SEspe/RemoteStart/docs/hardware/MasterRemote_interface_schematic_marked.jpg

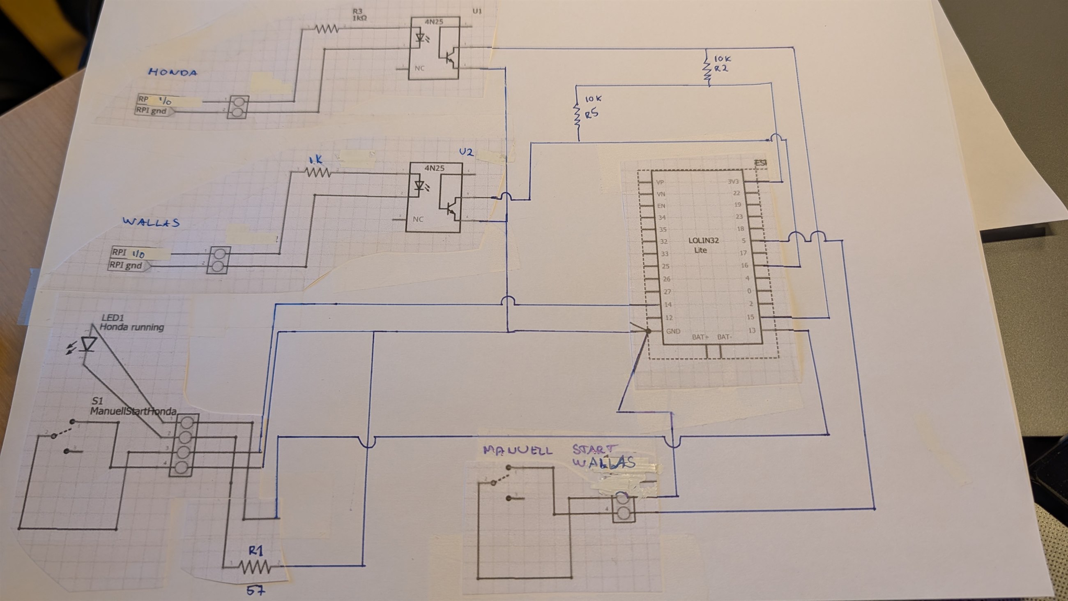
docs/hardware/MasterRemote_interface_schematic_marked.jpg
