SEspe/RemoteStart/docs/hardware/Wallas_connector_onoff_thermostat.png

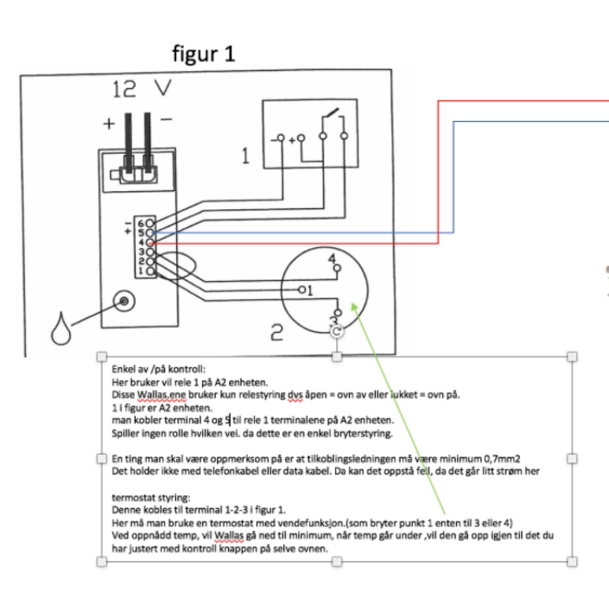
docs/hardware/Wallas_connector_onoff_thermostat.png
