SEspe/RemoteStart/FSD_RemoteStart_CHANGELOG.md

# FSD changelog — Remote Start System

The development record for `FSD_RemoteStart.md`. Every change to the
specification lands here, newest first.

The two files have different jobs. **`FSD_RemoteStart.md` is the clean current
specification**: what the system is required to do, in the present tense, with
no history in it. **This file is how it got that way** — what changed at each
version, and more importantly *why*, so a decision that looks arbitrary later
can be traced back to the evidence that forced it.

Read the FSD to build the thing. Read this when you want to know why it says
what it says, or before reopening a question that was already settled. This
project is the origin of the house conventions the sibling projects inherit —
the provisioning portal, the tab layout, the OTA flow — so several entries here
are cited by name in those projects' specifications.

Entry format: `- vX.Y — **Title.** what + why + how`, with per-unit firmware
versions named where they changed (MasterRemote, SlaveHonda, SlaveWallas,
ESPNowRelay). A functional change is not done until the code, the unit version
bumps, and an entry here land together.

---

- v1.62 — **The ESP32-C6 relay module's relay is on GPIO19** — the pin SlaveWallas already drives, so the board runs the standard SlaveWallas release with no board setting. Confirmed on the bench (board MAC `98:A3:16:9D:8D:0C`, SlaveWallas 1.8.0, flashed with the browser flasher): three Start/Stop pulses through `/api/wallas/start|stop` gave three audible on/off clicks, with `relay` and GPIO19 following, active HIGH. Hardware Guide §3.2 updated from "not yet known"; GPIO18/GPIO23 have nothing attached on this board. Documentation only.

- v1.61 — **Every unit answers on a fixed name, and the setup page takes you there by itself** (§4). MasterRemote 1.9.0, SlaveHonda 1.5.0, SlaveWallas 1.8.0, ESPNowRelay 1.3.0.
  - **Why:** after entering WiFi details in the portal the unit rebooted onto the home network at a DHCP address nobody was told; finding it meant digging through the router.
  - **mDNS + DHCP hostname on all four units:** `masterremote`, `slavehonda`, `slavewallas`, `espnowrelay` (`MDNS_HOSTNAME` in each `version.h`). The hostname is set on the STA netif before DHCP starts, so router client lists show it; mDNS (`espressif/mdns`, the same component as BirdBox) announces `<name>.local` and an `_http._tcp` service. Best-effort: a failed `mdns_init()` only logs. Same-subnet only.
  - **Self-redirecting Saved! page:** after **Connect & Save** (portal or WiFi tab) or **Save & Apply** (IP Configuration), the page polls `http://<name>.local/api/version` (`no-cors` fetch, 3 s abort, every 2 s from 6 s after saving, ~90 s in all) and opens `http://<name>.local/` as soon as the unit answers. The manual fallback stays on the page: the link, the router client list, and for the slaves MasterRemote's Nodes tab. One `SAVED_PAGE(msg)` macro per unit replaces the two old static pages.
  - **Told up front:** a note under each of those three buttons says where the page will go after saving. The portal's note adds that a phone's automatic "sign in to network" window can't follow (it closes with the AP), so 192.168.4.1 should be opened in a normal browser tab.
  - README First Startup, the browser flasher's instructions and FSD §4 (table now lists all four units with their address after setup) describe the new flow.
  - **Verified on the test SlaveWallas** (1.8.0, PC on the same 192.168.10.x subnet): `slavewallas.local` resolved to .220 and served the UI; a real save (IP Configuration, settings unchanged) returned the new Saved! page, the unit rebooted, and headless Chrome followed the page to `http://slavewallas.local/` on its own; settings came back unchanged. MasterRemote, SlaveHonda and ESPNowRelay built and their UI JavaScript parses, but were not run (no bench units online for them).

- v1.60 — **MIT license added** (`LICENSE`, "Copyright (c) 2026 SEspe", same as BirdBox). Its as-is / no-liability clause backs the safety disclaimer (v1.59). The README gains a License section, which also states that the Wallas wiring drawing and the relay-module product photo in `docs/hardware/` are third-party material, included for reference and not covered by the MIT license. Documentation only.

- v1.59 — **Safety precautions and an at-your-own-risk disclaimer for connecting SlaveWallas to a heater.** Documentation only. The Wallas wiring (Hardware Guide §3.1–3.2) is worked out from a third-party drawing for one older Wallas M26 and is not verified for anyone else's heater, while the system starts a fuel-burning appliance remotely and on a timer, possibly unattended. Hardware Guide 1.2 now opens §3 with a prominent CAUTION block: check the heater's own documentation or a dealer, measure terminals 4/5/6, keep the heater's own safety functions in charge, fuse the feed, use NO and ≥ 0.7 mm², bench-test then test at the heater while present, only use remote/timer starts where unattended running is safe — and do not connect if any of it cannot be confirmed. It ends with a no-warranty, no-liability, at-your-own-risk disclaimer. A short banner at the top of the guide, a reminder in §3.2, and a "Safety and disclaimer" section in the README point to it.

- v1.58 — **Removed the old Arduino sketches.** Repository cleanup only — no firmware change. Five `.ino` files were still committed although no build used them and the FSD and README both say the project has no Arduino code: `MasterRemote/MasterHonda.ino`, `SlaveHonda/SlaveHonda.ino`, `SlaveWallas/SlaveWallas.ino`, and `SlaveWallas/SlaveWallas8266.ino` plus an identical copy under `SlaveWallas/Archive/`. They remain in git history; the last commit containing them is `fbca35c`, so e.g. `git show fbca35c:MasterRemote/MasterHonda.ino` prints one.

- v1.57 — **Wallas wiring documented; ESP32-C6 relay module planned for SlaveWallas** ([Hardware Guide §3.1–3.2](docs/HARDWARE.md#31-wallas-heater-control-terminals)). Documentation only — no firmware change. The heater's 12 V control block: terminal 6 −, 5 +, and joining 4 to 5 runs the heater (open = off); terminals 1–2–3 are an alternative thermostat input, unused. SlaveWallas is wired as: module supply from 5/6, relay COM to 5, NO to 4 — NO so that an unpowered board leaves the heater off. The vendor drawing's note to use at least 0.7 mm² wire is carried over. The planned board is an ESP32-C6 single-relay module (DC 5–60 V, Type-C, BOOT/RST); its relay GPIO is not published and is to be found with the Debug tab before installation. The connector has no running-feedback signal, so GPIO18 stays unconnected. §2.4 now points to the guide.

- v1.56 — **SlaveWallas runs standalone; the weekly timer lives on both units and stays in sync** (new §3.5; §3.3, §3.4, §6.1a, §6.2, §13). MasterRemote 1.8.2, SlaveWallas 1.7.2, ESPNowRelay 1.2.0; SlaveHonda unchanged.
  - **Why:** SlaveWallas could only ever do what MasterRemote last told it. Without MasterRemote there was no way to run the heater, and if MasterRemote vanished mid-run the relay stayed in its last state indefinitely.
  - **Behaviour, as chosen by the user:** standalone is automatic — no Master beacon for 30 s (the existing stale rule), or none since boot. Standalone, the relay follows SlaveWallas's own Start/Stop and own weekly timer; so losing Master drops Master's sources and the heater turns off unless a local source wants it. With Master present, the relay follows Master's command as before, and SlaveWallas's Start/Stop are passed to Master and act exactly like Master's own buttons, so both pages agree. A local Start made while standalone is handed to Master when it returns, so the heater does not drop at the hand-over.
  - **Timer sync, newest edit wins:** both units keep the 7-day table plus a `walltrev` revision in NVS. An edit sets rev to the edit's wall-clock time (NTP; never lower than rev + 1). Each side sends its table every 60 s while the other is present, 1 s after an edit and immediately on (re)contact; the higher rev is adopted, a lower one is answered with the newer table. A pre-existing MasterRemote table counts as rev 1, so it is copied to a fresh SlaveWallas.
  - **Two new ESP-NOW messages** — `wallas_timer_msg_t` (71 bytes) and `wallas_webcmd_msg_t` (33 bytes), packed and size-asserted on every unit, since all units dispatch on frame length. **ESPNowRelay 1.2.0 forwards both;** an older relay would count them as "Other" and drop them, so with a relay in the path all three units must be updated together.
  - **SlaveWallas UI:** Status tab gains a Mode line and Start Wallas / Stop Wallas buttons; a new Weekly Timer tab (same table and staged Set as Master's). New `/api/wallas/start|stop`, `/api/timer`, `/api/timer/set`; `/api/status` adds `sa`/`lw`/`ta`. SlaveWallas now runs SNTP (same server and TZ as Master). `max_uri_handlers` 20 → 28.
  - **Weekly Timer tabs refresh themselves (both units).** The tab polls every 2 s but redraws only when `rev` changed, and never over unsaved edits or a field being typed in — then a note says the timer changed on the other unit, with a link to load the latest. Previously Master's tab only loaded on open, which made sync invisible until a manual reload. Also removed a stray "…" placeholder that rendered above the timer table.
  - **Master side:** command force-sent when SlaveWallas (re)registers or presses a button; `/api/timer` reports `rev`; `.warn` style added (the clock line was unstyled).
  - **Verified on the test pair** (MasterRemote .224, SlaveWallas .220, no relay): Start/Stop on SlaveWallas switched Master's `gWS` and the slave relay; timer edits went across in both directions within ~2 s with matching rev; with MasterRemote unplugged SlaveWallas went standalone (`sa:true`), its Start/Stop drove the relay directly, and a timer window covering the current time switched the relay on (`ta:true`) and off again when removed; after a reboot with no Master it came up standalone.

- v1.55 — **MasterRemote inputs: an unconnected input no longer demands a start, and each input can be switched off as a source** (§2.2, §6). MasterRemote 1.7.0; the other units are unchanged.
  - **Found on a bare test board flashed with the new browser flasher:** with nothing wired, MasterRemote 1.6.15 commanded both Honda and Wallas on. GPIO15/GPIO4 had their internal pull-ups disabled and relied on the interface board's 10 kΩ pull-ups, so without the board they read LOW, which is "Victron demands start". GPIO14/GPIO5 read HIGH through their pull-ups, which is a manual switch in its On position. The test SlaveWallas really did switch its relay on. The same thing would happen in the installation if the interface-board connector came loose or a switch wire broke, and for Honda a start command cranks the engine.
  - **Internal pull-ups enabled on GPIO15 and GPIO4.** With the board fitted this only adds to R2/R5 and the opto still pulls the pin LOW. Without it, the pin now reads HIGH = idle. Verified on the bare board: GPIO4/GPIO15 read 0 on 1.6.15, 1 on 1.7.0.
  - **Input enable mask.** The manual switches ground their pin when Off, so an open circuit reads On whatever the firmware does; the wiring fix is to use the switches' other contact. Until then, and for any unit with an input not fitted, the Debug tab has an **Input Sources** card with one checkbox per input, staged and saved with one **Set** button like the Weekly Timer. New `POST /api/inputs/set?mask=0-15`, NVS u8 `inen`, `inEn` in `/api/status`, all enabled by default. Pin Status labels a disabled input "(disabled)" but keeps showing its pin.
  - **One compute function per command.** The OR of all sources was written out at four sites per command (both ISRs, the boot read, `timer_task`, the web stop handlers). Adding the mask to each copy would have repeated the bug class in §12 that has already happened three times, so all sites now call `honda_cmd_compute()`/`wallas_cmd_compute()`. Changing the mask recomputes both commands at once and force-sends Honda if it changed.
  - `max_uri_handlers` raised 28 → 32 (27 routes now).
  - Verified on the test pair (MasterRemote .224, SlaveWallas .220): mask 5 (manual switches off) dropped `gHS`/`gWS` to false and the SlaveWallas relay went off; mask 99 was rejected with 400; the mask survived a reboot.

- v1.54 — **Browser flasher for a new unit, on GitHub Pages** (§11.1). A new board can now be flashed from https://sespe.github.io/RemoteStart/ in Chrome or Edge, with no ESP-IDF or esptool on that computer — the same esp-web-tools pattern as the BirdBox project, extended to four units on two chip families. CI/docs only — no firmware, endpoint or NVS change, and no unit version bump.
  - **New `.github/workflows/webflash-pages.yml`:** on a push to `master` that touches a unit or the flasher, builds all four units in a matrix and deploys each one's bootloader, partition table, OTA data and app image plus a per-unit `manifest.json` to Pages. One `docs/webflash/manifest.template.json` serves all four; the matrix fills in the unit, `FIRMWARE_VERSION`, chip family and **bootloader offset, which differs by chip — 0x1000 on ESP32, 0x0 on ESP32-C6** (read from each unit's `flasher_args.json`). Getting that wrong would write a C6 bootloader where the ROM never looks.
  - **Per-unit buttons, not one:** the four units are four different firmwares, so the page has one install button per unit. esp-web-tools refuses a chip-family mismatch, so the C6 units are protected against the wrong board; MasterRemote and SlaveHonda share the ESP32 family and cannot be told apart, which the page warns about.
  - **Erase is offered by default** (`new_install_prompt_erase`), because a plain flash onto a board with unknown history once left a new MasterRemote's radio silent while its logs reported a running SoftAP.
  - **Fixed the release notes' USB instructions:** they told the reader to `write_flash 0x10000 <Unit>_<ver>.bin` alone, which on a blank board leaves no bootloader or partition table and does not boot. They now point at the browser flasher or `idf.py erase-flash flash`, and say the release `.bin` files are OTA app images. §8 says the same.
  - `README.md` "Build & Flash" now leads with the browser flasher.

- v1.53 — **Specification and history split into two files.** Documentation only — no firmware, endpoint or NVS change, and no unit version bump. `FSD_RemoteStart.md` becomes the clean current specification — present tense, no history — and this file takes the development record, all 51 entries moved across byte-for-byte. This FSD was the mildest of the three (68 lines of changelog against 782 total), but the same split is now applied across all four sibling projects so the house convention stays uniform; a half-migrated family is worse than either extreme. **One internal cross-reference was broken by the move and is fixed:** §4's static-IP note cited "§1 changelog", which no longer exists in this document, and now names the changelog file. The other in-document references — to the v1.25, v1.27 and v1.31 entries in §10 and §12 — still resolve, because the FSD's new header says where the changelog lives. `README.md` lists both files.

- v1.52 — **Hardware documentation: new [docs/HARDWARE.md](docs/HARDWARE.md) plus the three source drawings under `docs/hardware/`.** Documentation only — no firmware, endpoint or NVS change, and no unit version bump. Covers MasterRemote's opto-isolated Venus (Raspberry Pi) interface board, the manual-switch/indicator field wiring and terminal-block assignments, the end-to-end Honda start flow through to the EU7000is remote connector, and the relay timing.
  - **Corrected §2.2: GPIO15 (Honda Start, Victron relay) is active LOW, not active HIGH.** The table had claimed active HIGH since v1.14 while `main.c` has always read it as `!gpio_get_level(PIN_HONDA_START)`. The schematic settles it — GPIO15 is fed by optocoupler U1's open collector with an external 10 kΩ pull-up, and the internal pull-up is disabled in `gpio_init()`. Confirmed live on 2026-08-10: with the system idle, `/api/gpio/status` reports GPIO15 = 1 and GPIO4 = 1, which is only possible with external pull-ups fitted, and `/api/status` correspondingly reads `pHS:false`/`pWS:false`. Both Victron inputs use the same polarity; the old text's "opposite polarity of GPIO15" note on the GPIO4 row was wrong for the same reason and is removed. No code changed — the firmware was already correct, only the document was not.
  - The **redrawn** schematic (`MasterRemote_interface_schematic.png`) was found to contain five transcription errors relative to the hand-marked original, catalogued in Hardware Guide §6 — most consequentially a right-header pin-label list with `23` and `15` duplicated and `5`/`2` missing, which shifts every row from the third down and makes the Wallas opto appear to land on GPIO16 rather than GPIO4. The marked original photo is kept alongside it and is the one to wire from until the redraw is fixed.
- v1.51 — **Collapsed the ~70 px of blank space under the "Install from GitHub Releases" card's buttons**, on all four units. The card reserved permanent room for controls that only appear once an install is under way: a `<br>` after the always-hidden release `<select>`, plus two `.prog` status lines each holding `min-height:1.2em` while empty. Removed the `<br>` (the select is switched to `display:block` when populated, so the Install button still lands on its own line) and added `.prog:empty{display:none}`, which collapses every idle status line on the page rather than just this card's. Purely CSS/markup; no endpoint, JSON, or NVS change. MasterRemote 1.6.15, SlaveHonda 1.4.13, SlaveWallas 1.6.13, ESPNowRelay 1.1.12.
- v1.50 — **Two fixes to v1.49's version table, both reported from the live UI.**
  - **MasterRemote showed no versions for the slaves.** v1.49 had the page fetch `/api/version` from each slave's own address; a browser treats `http://<slave-ip>/` as a different origin from the page it loaded off MasterRemote, and those reads came back empty in practice even with `Access-Control-Allow-Origin: *` on the response. Replaced by **`GET /api/versions[?relay=<ip>]` on MasterRemote**, which collects the other units' `/api/version` itself over plain LAN HTTP (4 s timeout each, so one silent unit can't stall the table) and returns all four rows to a same-origin caller. Slave addresses still come from the ESP-NOW roster; ESPNowRelay's is still typed once into the card and kept in the browser, now passed through as a query parameter (validated against an IPv4 alphabet before it goes into a URL). `/api/version` stays on every unit — it is the data source, and still CORS-open for direct use.
  - **24-hour clock everywhere.** `new Date().toLocaleTimeString()` follows the viewing browser's locale and was rendering as `7:43:39 PM`. All UI timestamps (Status/Nodes "Updated:", the version card) now go through one `hms()` helper producing zero-padded `HH:MM:SS`, on all four units.
  - Also: a stored version read from a pre-v1.49 image is a `git describe` string that already starts with `v`, which rendered as `vv1.31.0`; the leading `v` is now stripped before the display prefix is added.
  MasterRemote 1.6.14, SlaveHonda 1.4.12, SlaveWallas 1.6.12, ESPNowRelay 1.1.11.
- v1.49 — **Firmware Versions table on the OTA tab: GitHub / Stored / Installed side by side, on all four units** (§6.6, §7.3). Each unit's OTA tab now opens with a version card showing what the newest published release offers for it (**GitHub**), what sits in its inactive OTA slot (**Stored** — the previous image, still bootable), and what it is running (**Installed**); the Installed box turns amber when GitHub has a newer build. **MasterRemote's card lists all four units in one table**, like the reference layout the feature was modelled on.
  - **New `GET /api/version`** on every unit: `{"name","installed","stored","storedName","running"}`. `stored` comes from `esp_ota_get_partition_description()` on `esp_ota_get_next_update_partition()`, and is empty when that slot has never been written or holds no valid image. Served with `Access-Control-Allow-Origin: *` on purpose — MasterRemote's page fetches this same endpoint from the other units' addresses, which is cross-origin from the browser's point of view; the payload is read-only version data on a LAN-only device.
  - **New `GET /api/ota/github/latest`** on every unit: the newest published version per unit, `{"MasterRemote":"…","SlaveHonda":"…","SlaveWallas":"…","ESPNowRelay":"…"}`, parsed out of the `<Unit>_v<ver>.bin` asset filenames. Reuses v1.48's streaming scanner (never materialises the listing) and captures only `browser_download_url`, stopping as soon as all four are known — normally inside the first release, since a unified `v*` tag carries all four bins. All four firmwares carry the identical four-unit handler even though only MasterRemote's page reads more than its own key.
  - **`PROJECT_VER` is now derived from `main/version.h` in each unit's top-level `CMakeLists.txt`**, so the app descriptor baked into the image carries `FIRMWARE_VERSION`. Without this, ESP-IDF fills the descriptor from `git describe`, which says nothing about the per-unit firmware version — and the descriptor is the only way to read a *passive* partition's version. **Consequence on first deploy: the Stored column shows a `git describe`-style string (or blank) until each unit has been updated twice**, since the image already in the passive slot predates this change.
  - **How MasterRemote resolves the other three addresses:** SlaveHonda and SlaveWallas come from `/api/nodes` (so the table follows a DHCP move), while **ESPNowRelay is deliberately absent from the ESP-NOW roster** — the repeater is transparent and never announces itself (§13) — so its address is typed once into a field on the card and kept in the browser's `localStorage`. That was chosen over adding a relay→Master ESP-NOW message type purely to feed a display, since the repeater's whole design premise is that it changes nothing about the other units' firmware. A blank or unreachable address just leaves that row's cells empty; per-unit fetches are abort-timeout bounded so one silent unit can't stall the table.
  - ESPNowRelay's `max_uri_handlers` raised 16 → 20 for the two new routes (the other three units already had margin).
  MasterRemote 1.6.13, SlaveHonda 1.4.11, SlaveWallas 1.6.11, ESPNowRelay 1.1.10. No NVS, data-model, or wire-format change.
- v1.48 — **Two independent defects were breaking the GitHub-release OTA feature; both are fixed, plus a "Go GitHub" link and MasterRemote's missing Manual GPIO Test card.** User reported the feature not working on all units. Probing SlaveHonda live separated it into two unrelated causes that had been mistaken for one:
  - **(1) Release listing ran out of heap.** `GET /api/ota/github/releases` buffered the whole API response and handed it to `cJSON`. Each published release carries four per-unit assets of ~20 JSON fields, so the listing had grown past **68 KB**, and a full parse needs the raw buffer plus a tree several times its size against a ~200 KB heap. MasterRemote failed **3/3** with `Bad GitHub response` (the `cJSON_Parse()` branch — the malloc succeeded, the parse then had nothing left), its heap low-water plunging ~98 KB per attempt, while SlaveHonda with a little more headroom still squeaked through **9/9**. That difference is why it looked intermittent. Rewritten as a **byte-at-a-time streaming scanner** (`gh_key_feed()`) that never materialises the document: it watches for four literal keys, exploiting GitHub's field order (`tag_name`/`published_at` precede a release's `assets`; within an asset `size` precedes `browser_download_url`), takes the asset filename from the URL's own last path segment, and dedupes by tag so one asset per release is emitted. Peak cost no longer depends on the release count — which matters because the payload grows with every release, so trimming `per_page` would only have postponed this. Output JSON is byte-identical to the old implementation (verified live: same 1348 bytes, same 7 releases). Also now tolerates a chunked response, since the scanner no longer needs `Content-Length`, and a non-200 reply reports the actual status code instead of a generic string.
  - **(2) Outbound TLS could not get a socket.** With the listing fixed, `POST /api/ota/github/install` still failed instantly with `begin:ESP_ERR_HTTP_CONNECT`, trace `le=32770` = `0x8002` = **`ESP_ERR_ESP_TLS_CANNOT_CREATE_SOCKET`** — `socket()` itself failing, nothing to do with TLS or the buffer sizes v1.46 fixed. `CONFIG_LWIP_MAX_SOCKETS` was **10**, while httpd holds a listener, a control socket, and up to 7 sessions = 9, leaving exactly **one** descriptor for everything else. A browser parked on a polling tab fills all 7 session slots (they are keep-alive and `lru_purge_enable` only reclaims one when a *new* connection needs it, so an idle wait does not help — confirmed: still failing after 60 s quiet), so the device had no descriptor left to open its own outbound connection. Proven by a discriminating test: after a reboot with no preceding traffic the identical install ran **0%→100% success**. Fixed by raising `CONFIG_LWIP_MAX_SOCKETS` to **16** in all four `sdkconfig.defaults`, and `cfg.max_open_sockets` is now set explicitly with a comment recording that it is one half of a budget, so a future change to either number is visibly a trade against the other. This affected *both* the listing fetch and the install, so it was very likely also a contributor to the user-visible "Refresh Releases doesn't work".
  - **(3) "Go GitHub" link** added beside Refresh Releases on every unit's OTA tab, opening `github.com/SEspe/RemoteStart` in a new tab (`rel="noopener"`). Styled via a new `a.up.gh-link` rule because the existing `button.up` selector is element-qualified and gives an `<a>` none of its padding or colour.
  - **(4) MasterRemote gained the Manual GPIO Test card** its Debug tab was missing (the other three units had it since v1.40). Same pin matrix, same reserved-pin rules, same `/api/gpio/set` + `/api/gpio/status` endpoints. **One difference is called out in its UI and worth knowing:** unlike the slaves, whose drivable pins are their own relay outputs, MasterRemote's Victron-relay and manual-switch pins are *inputs fed by external contacts* (§2) — the strapping-pin rules already exclude GPIO5/GPIO15, leaving **GPIO4 and GPIO14** as pins where forcing OUTPUT puts the pad in contention with the external wiring. Reading their dots is always safe; driving them is not, unless that wiring is disconnected. `cfg.max_uri_handlers` raised 22→28, since the two new routes brought the count to exactly 22 — the exact-fit cap that silently dropped a route in v1.27/§12.
  MasterRemote 1.6.12, SlaveHonda 1.4.10, SlaveWallas 1.6.10, ESPNowRelay 1.1.9. New routes on MasterRemote only; no NVS, data-model, or wire-format change.
- v1.47 — **The WiFi tab now states the configured WiFi network and the addressing actually in use, on all four units.** Two gaps: (1) a unit's provisioned SSID was written to NVS at setup and then never shown anywhere in the UI — the WiFi tab's SSID box sat empty with a `tap network or type` placeholder, so the only way to tell which network a unit was on was to read it off the router; (2) the IP Configuration card's live readout omitted both the address *source* and the DNS server, so a `192.168.1.101` on screen didn't say whether it was the static address configured on this unit or a lease the router happened to hand out — a meaningful distinction now that all four units are statically addressed (§10.2). The **WiFi Network** card gains a live grid above the form with **Configured SSID** and **Connected To** rows, and the SSID input is now pre-filled with the configured value when empty (same prefill-don't-overwrite convention as v1.38's static-IP fields — a password-only change no longer means retyping the SSID). The two SSID rows are deliberately separate values, not one: `ssid` comes from the STA driver config and is present whenever the unit is provisioned, while `apSsid` comes from `esp_wifi_sta_get_ap_info()` and is only non-empty while genuinely associated — so a unit that is provisioned but off the air (SlaveHonda in its ESP-NOW-only fallback, §5.2, or any unit mid-reconnect) reads `Configured SSID: <name>` / `Connected To: not associated`, which distinguishes "wrong/lost credentials" from "credentials fine, radio can't reach the AP". The **IP Configuration** card's live grid gains an **Address Source** row (`Static (configured)` / `Automatic (DHCP)`) and a **DNS Server** row; every live field is read back from the STA netif rather than from the saved config, so it reports the address genuinely in effect in both modes — including the case where a static config failed validation at boot and `apply_static_ip()` silently fell back to DHCP (§4), which previously showed no visible difference. Switching to Static now also pre-fills the DNS field from the live value, completing the v1.38 prefill set (live DNS wasn't available to the UI before this change). `GET /api/ipconfig` gains `ssid`, `apSsid`, and `liveDns`; response buffer grown 400→600 bytes to fit two 32-char SSIDs. SSID JSON escaping (quote/backslash/control-char handling, previously inline in `/api/scan`) is factored into one `ssid_json_esc()` helper per unit and shared by both endpoints. MasterRemote 1.6.10, SlaveHonda 1.4.8, SlaveWallas 1.6.8, ESPNowRelay 1.1.7; endpoint-response-additive only, no NVS, data-model, or wire-format change.
- v1.46 — **Fixed v1.45's GitHub-releases install actually failing on real hardware** (`begin:ESP_FAIL` immediately, 0%, on every unit) — the feature was built, deployed, and its release-listing worked, but the install step itself was broken until now. Root cause, found live via a new HTTP-event trace (added specifically because there's no USB/serial access to these units in normal operation): GitHub's release-asset redirect target is a **signed URL around 2 KB long** (JWT query params via `release-assets.githubusercontent.com`). `esp_http_client` builds the outgoing `GET <path>?<query> HTTP/1.1` request line for the redirected request into `buffer_size_tx`, a **separate TX buffer from `buffer_size`** (which is RX-only) that still defaulted to 512 bytes even after `buffer_size` had already been bumped to 4096 for the RX side — the oversized request line silently failed with "Out of buffer" (an `esp_http_client`-internal `ESP_LOGE`, invisible without serial access) and `esp_https_ota_begin()` surfaced it as a bare `ESP_FAIL` with no further detail. Fixed by also setting `buffer_size_tx = 4096` on the OTA download's `esp_http_client_config_t`. Verified live end-to-end on ESPNowRelay before rolling out to the other three: release list fetched, install progressed 0%→95% as real percentages, device rebooted cleanly onto the new image. **New permanent diagnostic: an HTTP-event trace** (`gh_http_event_handler`, connect/redirect/status/data-chunk/error events, including decoded `esp_tls_last_error_t` fields on `HTTP_EVENT_ERROR`) is now wired into the GitHub-install client on all four units and exposed as a `trace` field on `GET /api/ota/github/progress` — kept intentionally (not stripped after the fix) since it's what made this diagnosable at all without USB access, and the failure mode (a CDN changing its redirect URL shape) could plausibly recur. New `esp-tls` component added to all four units' `CMakeLists.txt REQUIRES` for `esp_tls_last_error_t`. MasterRemote 1.6.9, SlaveHonda 1.4.7, SlaveWallas 1.6.7, ESPNowRelay 1.1.6; no data-model or wire-format change, endpoint-response-additive only (`trace` field).
- v1.45 — **OTA tab (all four units) gains a second, alternative install path: browse and install directly from this repo's GitHub Releases, no manual `.bin` download needed.** A new "Install from GitHub Releases" card sits above the existing manual-upload card. **Refresh Releases** hits `GET /api/ota/github/releases`, where the device itself calls `api.github.com/repos/SEspe/RemoteStart/releases` (unauthenticated, `per_page=8`, `esp_crt_bundle_attach` for TLS) and returns only the releases that include a binary matching this unit's `FIRMWARE_NAME` (e.g. a `wallas-v*` single-unit release doesn't show up on MasterRemote's picker) — releases without a match are silently omitted, not greyed out. Picking one and clicking **Install Selected** POSTs `{url,size}` to `POST /api/ota/github/install`, which validates the URL is actually under `https://github.com/SEspe/RemoteStart/releases/download/` (rejects anything else — defends against a crafted request pointing the device at an arbitrary host) and spawns a background task (`gh_ota_task`, not the httpd worker) that streams the download straight into flash via `esp_https_ota()`'s advanced perform-loop API, tracking bytes-read against the asset's known size for a live percentage. A new `GET /api/ota/github/progress` endpoint is polled every second by the OTA tab to drive a real progress bar during the download — chosen over a plain spinner specifically because MasterRemote's weak WiFi (§12, RSSI -85 to -92 dBm typical) can make a multi-second install look indistinguishable from a hang without one. On success the device reboots exactly like the existing upload path; on failure the tab shows the `esp_err_to_name()` string and re-enables the controls. New build dependencies (`esp_http_client`, `esp_https_ota`, `mbedtls` for `esp_crt_bundle.h`) added to all four units' `CMakeLists.txt REQUIRES`; cJSON is now pulled in as the managed component `espressif/cjson` via `idf_component.yml` (ESP-IDF v6 removed the old in-tree `json` component name). `cfg.max_uri_handlers` bumped from 16→20 on SlaveHonda/SlaveWallas while adding the three new routes, since they were down to 1 spare slot above the exact-fit-cap failure class documented in v1.27/§12. MasterRemote 1.6.8, SlaveHonda 1.4.6, SlaveWallas 1.6.6, ESPNowRelay 1.1.5; additive endpoints only, no wire-format (ESP-NOW) or existing-JSON-field change. The existing manual file-upload OTA path is unchanged and remains the fallback if GitHub is unreachable.
- v1.44 — **The Wallas Manual switch on MasterRemote was physically reconnected, reversing the v1.29 "permanently unwired" status.** Confirmed live via `/api/status` with the switch in its "Off" position: `pWM` (the pre-existing, then-meaningless diagnostic field, formula `!gpio_get_level(GPIO5)`) read `true`, meaning the **raw pin is LOW when Off** — i.e. this switch is **non-inverted/active-HIGH** (On demands start), the *opposite* of GPIO4's active-LOW Victron relay input, but the *same* convention as GPIO14's Honda manual switch (which is also read non-inverted): both apparently ground their pin in the idle/off position and float pulled-up HIGH when active. An initial version of this change wrongly assumed GPIO5 would mirror GPIO4's active-LOW polarity by analogy — caught before OTA deploy by checking live `/api/status` first, which is why every hardware-polarity assumption in this codebase gets a "verify against the physical unit" callout (§12). Fixed to read `gpio_get_level(PIN_WALLAS_MANUAL_START)` directly, matching `PIN_HONDA_MANUAL_START`'s pattern. This is a **maintained on/off toggle**, not momentary, and OR's in as a plain level source alongside the Victron relay, web override, and weekly timer: On continuously demands Wallas start, Off just stops contributing to the OR (another source can still keep Wallas running). Restored across all four recompute sites (`isr_wallas_recompute`, `gpio_init()`'s boot-time read, `timer_task`, `h_wallas_stop`) and re-attached its ISR handler, per the §12 OR-recompute rule. `/api/status`'s `pWM` field also flipped to non-inverted to match the corrected command logic; UI label dropped "unused". MasterRemote-only (1.6.6); no data-model or wire-format change. **Not yet verified against the physical switch's On position** — confirm `gWS`/`pWM` flip correctly and the physical relay engages before relying on it.
- v1.43 — MasterRemote's Nodes tab IP column is now a clickable link (`target="_blank"`) that opens the slave's own web UI in a new tab, when an IP is known — previously it was plain text, requiring a manual copy/retype into the address bar. No link is rendered (falls back to "—") when the node has no IP (e.g. SlaveHonda in ESP-NOW fallback). MasterRemote-only, web UI change (1.6.5), no API/JSON change.
- v1.42 — **MAC addresses now visible on every unit's own Radio Link/WiFi Link card, and ESPNowRelay gains an ESP-NOW peer RSSI/MAC summary there too.** (1) All four units' `/api/status` now includes the device's own STA MAC (`esp_wifi_get_mac(WIFI_IF_STA, ...)`) as `mac`, shown as a new "Own MAC" row — previously a unit's own MAC was only visible indirectly, e.g. via MasterRemote's Nodes tab or ESPNowRelay's Peers table, not from the device's own page. (2) SlaveHonda/SlaveWallas's Radio Link card gains a **Master MAC** row: the two slaves already tracked MasterRemote's MAC (`g_master_mac`, learned from the discovery beacon) but it was `static`/file-local and never surfaced in the web UI or `/api/status` — exposed as `masterMac` (empty string, shown as "not discovered", until the beacon is heard). (3) ESPNowRelay's Debug tab card, renamed **WiFi Link → Radio Link** (matching the slaves), gains three new rows summarizing each tracked peer (MasterRemote/SlaveHonda/SlaveWallas): RSSI + MAC in one line, or "not discovered" — this data already existed in the Peers table on the Status tab, just not on Debug alongside the other radio-link diagnostics. MasterRemote 1.6.4, SlaveHonda 1.4.5, SlaveWallas 1.6.5, ESPNowRelay 1.1.4; additive JSON change only, no wire-format change.
- v1.41 — **SlaveHonda/SlaveWallas's Radio Link card (renamed from "WiFi Link") now also shows the ESP-NOW RSSI/channel of the last frame heard from MasterRemote**, alongside the existing WiFi AP RSSI/channel. This value already existed (`g_espnow_rssi`/`g_espnow_channel` in `main.c`, sourced from `esp_now_recv_info_t.rx_ctrl` and sent to MasterRemote in every heartbeat for its Nodes tab), but was previously only visible remotely, on MasterRemote's own UI — a slave had no way to see its own ESP-NOW link quality to Master without checking a different device. `/api/status` on both slaves gains `enRssi`/`enCh` fields. Useful because the WiFi and ESP-NOW RSSI values can genuinely differ: WiFi RSSI is the slave's link to the router; ESP-NOW RSSI is its direct (or relayed, via ESPNowRelay) link to MasterRemote, a different path entirely once ESPNowRelay is involved (§13). SlaveHonda 1.4.4, SlaveWallas 1.6.4; additive JSON change only, no wire-format change (the field already existed in the heartbeat struct).
- v1.40 — **Standardized the tab bar across all four units: Status | Debug | *(unit-specific tabs)* | WiFi | OTA Update.** Previously MasterRemote and ESPNowRelay had no Debug tab at all (their WiFi Link + System cards sat directly on the Status tab), and SlaveHonda/SlaveWallas's existing tab was labeled "Debug GPIO" even though it also held the System resource monitor, not just the GPIO test tool. Renamed "Debug GPIO" → **Debug** on both slaves, and added a new **Debug** tab to MasterRemote (inserted after Pin Status) and ESPNowRelay (inserted after Status). On all four units, the **WiFi Link** card (AP RSSI + channel) and **System** card (heap/uptime/reconnects, §10.1) now live on the Debug tab, not Status — Status/Pin Status keeps only the operational data (relay/pin states, node roster controls, traffic/peer tables). Purely a UI reorganization: no endpoint, JSON, or NVS changes. Each unit's polling loop was updated so the WiFi Link/System cards still refresh every 2 s while the Debug tab is open (previously that refresh was gated on the Status tab being active). MasterRemote 1.6.3, SlaveHonda 1.4.3, SlaveWallas 1.6.3, ESPNowRelay 1.1.3.
- v1.39 — Added a **Last WiFi Reconnect** field next to the existing WiFi Reconnects counter on `/api/sysinfo`'s System card, all four units. Motivated by a user report of 12 reconnects across all four units in 20 hours — the existing counter alone couldn't distinguish a synchronized, shared router/AP-side disruption (all units dropping within the same few seconds — points at the router: a power blip, scheduled reboot, DHCP renewal, or channel interference) from independent per-unit RF flakiness (each unit's own marginal signal, unrelated timing). New `g_wifi_last_disc_ts_us` (`esp_timer_get_time()` at the moment of each `WIFI_EVENT_STA_DISCONNECTED`) is set alongside the existing counter incrementing; `/api/sysinfo` gains `wifiDiscAgo` (seconds since, or `-1` if none since boot). Querying all four units within a few seconds of each other and comparing this field settles the question directly. MasterRemote 1.6.2, SlaveHonda 1.4.2, SlaveWallas 1.6.2, ESPNowRelay 1.1.2; additive JSON change only.
- v1.38 — Two follow-ups to the v1.37 WiFi tab, on all four units. (1) Selecting **Static IP** now pre-fills any empty IP/subnet mask/gateway field with the unit's currently-active (live, DHCP-assigned) values as a starting suggestion, instead of leaving them blank — the JS `ipModeChange()` handler only fills a field if it's currently empty, so it never clobbers a value already saved or typed. (2) Added a **Device** card to the WiFi tab with a **Reboot Now** button (`confirm()` dialog, then `POST /api/reboot`) — previously the only way to reboot a unit outside an OTA upload or config-portal save was a physical power cycle or USB reset. MasterRemote 1.6.1, SlaveHonda 1.4.1, SlaveWallas 1.6.1, ESPNowRelay 1.1.1; additive JS/API change only.
- v1.37 — **New always-accessible WiFi tab (all four units) with DHCP/static IP selection.** Previously, WiFi network (SSID/password) settings were only reachable via the first-boot `/wifi-setup` config portal — the route stayed registered during normal operation too, but nothing ever consumed a save submitted outside the portal's own blocking wait loop, so changing credentials from an already-running unit silently did nothing. Fixed as part of this change: a new `config_apply_task` (spawned in `app_main` on all four units) watches `g_wifi_save_requested`/`g_ipcfg_save_requested` for the life of the device and persists + reboots on either, so the web UI's WiFi tab is now genuinely functional at any time, not just during initial setup. The new **WiFi** tab (added to every unit's tab bar, alongside Status/Debug/Nodes/etc.) has two cards: **WiFi Network** (unchanged SSID/password form + scan, now embedded directly in the dashboard instead of only the standalone portal page) and **IP Configuration** — a DHCP/Static IP radio (DHCP is the default and unchanged behavior), with IP address/subnet mask/gateway/DNS fields shown only in Static mode. Saving either card reboots the unit to apply. Backend: new NVS keys `ipmode`/`ip`/`mask`/`gw`/`dns` (same `NVS_NAMESPACE` as WiFi credentials — erasing NVS to reset WiFi credentials, §4, also resets IP config back to DHCP); `apply_static_ip()` in `main.c` calls `esp_netif_dhcpc_stop()` + `esp_netif_set_ip_info()` (+ `esp_netif_set_dns_info()` if a DNS server is set) on the STA netif before `esp_wifi_start()`, applied only when a saved static IP/mask are both present and pass `esp_netif_str_to_ip4()` validation — an invalid saved config silently falls back to DHCP rather than leaving the unit unreachable. New endpoints `GET /api/ipconfig` (saved config + the currently-active IP/mask/gateway) and `POST /api/ipconfig/save` (mode/ip/mask/gw/dns, server-side IPv4 syntax validation before accepting — a syntactically-parseable-but-wrong static IP would otherwise still let the unit associate to the AP, just leaving it unreachable over IP, indistinguishable from a hang). **Caveat:** a wrong-but-valid-looking static IP (e.g. outside the actual LAN's subnet) is not detected by this validation and requires the same USB/NVS-erase recovery as a lost WiFi password (§4/§10). MasterRemote 1.6.0, SlaveHonda 1.4.0, SlaveWallas 1.6.0, ESPNowRelay 1.1.0; additive JSON/NVS change, no wire-format (ESP-NOW) change.
- v1.36 — **Fixed all output-pin status readbacks by configuring status-relevant outputs as `GPIO_MODE_INPUT_OUTPUT`** — resolves the long-standing §12 limitation for good. User-reported: SlaveHonda physically sequences correctly (ignition on → crank), but the web UI's Ignition/Starter dots showed **true all the time**. Root cause: a plain `GPIO_MODE_OUTPUT` pin has its input buffer disabled on ESP32, so `gpio_get_level()` always returns 0 — through SlaveHonda's active-LOW inversion that stuck 0 rendered as permanently-true dots, while SlaveWallas's non-inverted `relay`/`led` fields and MasterRemote's `pFB` read permanently *false* by the same mechanism. `GPIO_MODE_INPUT_OUTPUT` additionally enables the read-back buffer (no electrical difference for a push-pull output), so `gpio_get_level()` now returns the genuinely driven pin level and every status dot reflects true hardware state. Applied to SlaveHonda (starter/ignition relays + both LEDs), SlaveWallas (heater relay + both LEDs), MasterRemote (Honda-running FB LED + status LED); ESPNowRelay unaffected (no output readbacks). The §12 caveat about untrustworthy output readbacks is now obsolete and marked resolved. MasterRemote 1.5.10, SlaveHonda 1.3.11, SlaveWallas 1.5.10; no data-model or API change.
- v1.35 — **Root-caused and fixed the day-long intermittent "web server unreachable while ESP-NOW keeps working" pattern on all units: httpd session-socket exhaustion.** ESP-IDF's `HTTPD_DEFAULT_CONFIG()` allows 7 concurrent session sockets with `lru_purge_enable` **off** — every client connection abandoned without a clean close (a browser keep-alive, a monitoring poll that hit its client-side timeout, a process exiting mid-request) permanently occupies a slot, and once all 7 are held by dead sessions the server stops servicing HTTP entirely until a reboot. Definitively diagnosed live on MasterRemote: ICMP ping fine (6–10 ms), raw TCP handshake to :80 *accepted* (lwIP's kernel-level backlog), but HTTP requests never serviced — the application-level worker had no free session slots. This, alongside the v1.32 power-save latency, was the second half of the recurring flakiness: heavy status polling with hard client timeouts (as done throughout 2026-07-02) is exactly the traffic pattern that leaks sessions fastest, which is why the units being actively monitored were the ones that kept wedging, and why a reboot always "fixed" it. Fixed with `cfg.lru_purge_enable = true` on **all four units** — when the pool is full, the least-recently-used session is evicted to admit the new connection (the standard ESP-IDF remedy; worst case an idle browser tab gets its keep-alive dropped and transparently reconnects). MasterRemote 1.5.9, SlaveHonda 1.3.10, SlaveWallas 1.5.9, ESPNowRelay 1.0.1; no data-model or API change.
- v1.34 — **New fourth unit: ESPNowRelay (ESP32-C6, v1.0.0)** — an optional store-and-forward ESP-NOW relay/repeater that extends radio reach between MasterRemote and a slave that can't hear it directly (§13). Designed as a **transparent proxy requiring zero firmware changes on the existing three units**: it re-broadcasts MasterRemote's discovery beacon verbatim (a far slave adopts the relay as its "Master" and heartbeats to it), forwards those heartbeats verbatim to the real Master (which registers the relay's MAC as that role's holder), and forwards Master's commands verbatim to the real slave (destination picked from the command's label). Trust and direct↔relayed failover come free from the existing MAC + 30 s staleness rules — every unit trusts its immediate radio peer, whichever path a unit hears consistently holds the role claim, and a stale path re-homes automatically. When all direct links are healthy the relay sits in passive standby. Same infrastructure as the other units: web UI (Status tab with per-class traffic counters — Rx/Fwd/Fail, last sender/receiver MAC, RSSI, last seen — a live peer roster, WiFi Link and System cards; OTA Update tab), first-boot config portal (`ESPNowRelay-Config`), `/api/sysinfo`, `WIFI_PS_NONE` + max TX power, indefinite post-boot WiFi reconnect, URL-decoded portal credentials, httpd handler-cap headroom + checked registration — all prior lessons applied from day one. WiFi-preferred with SlaveHonda-style ESP-NOW channel-scan fallback (relays without an IP/web UI if the router is unreachable). Onboard LED (GPIO2): fast blink = traffic forwarded within the last 10 s, slow = idle/standby. CI: new `build-relay` job, `relay-v*` single-unit tag pattern, and inclusion in unified `v*` releases.
- v1.33 — Both slaves' Status tab gains a **WiFi Link** card (AP signal strength in dBm + channel), mirroring MasterRemote's — previously the slaves' own web UI showed no radio info at all, so judging their router link quality required checking MasterRemote's Nodes tab (which shows the ESP-NOW link RSSI, a different radio path) or guessing. `/api/status` on both slaves gains `rssi`/`ch` fields sourced from `esp_wifi_sta_get_ap_info()`; if the STA isn't associated (SlaveHonda in ESP-NOW fallback — though its web UI is unreachable in that state anyway), the fields read 0 and the UI shows "not associated". SlaveHonda 1.3.9, SlaveWallas 1.5.8; additive JSON change only.
- v1.32 — Disabled WiFi modem-sleep power save (`esp_wifi_set_ps(WIFI_PS_NONE)`) and set max TX power (`esp_wifi_set_max_tx_power(84)`, 21 dBm) on all three units, right after `esp_wifi_start()` on the STA connect path. Motivated by a persistently flaky web server on SlaveWallas even after a fresh reconnect at good RSSI (-60 dBm) — the default modem-sleep power save (confirmed active in the boot log: `wifi:pm start, type: 1`) makes the radio sleep between beacons and only wake at DTIM intervals to receive buffered packets, adding latency to every HTTP exchange independent of raw signal strength; combined with any marginal link, this compounds into the timeout/flakiness pattern seen throughout 2026-07-02. Max TX power improves the uplink (how well the router hears each unit) but doesn't affect the RSSI *readings* these units report (that's the router's TX power, which isn't under this firmware's control) — it's a secondary, low-cost improvement, not the primary fix. `set_max_tx_power` isn't `ESP_ERROR_CHECK`'d since the true ceiling is module-dependent; a rejected value just logs a warning and leaves the IDF default in place. All three units: MasterRemote 1.5.8, SlaveHonda 1.3.8, SlaveWallas 1.5.7; no data-model or wire-format change.
- v1.31 — **Fixed a live safety bug in v1.30's running-feedback exclusion: SlaveHonda was re-cranking the starter on an already-running engine roughly every 30 seconds.** Confirmed on the physical generator: a manual Start Honda from MasterRemote's web UI started the generator successfully, but the Debug tab's "starting" indicator kept flickering back to green and ignition/starter kept appearing active well after the ~14 s start sequence should have finished. Root cause: `send_status()` (SlaveHonda's 10 s heartbeat) unconditionally forced `g_honda_running = false` on every call, stomping whatever `honda_start()` had just set — so SlaveHonda *always* reported "not running" to MasterRemote no matter what actually happened. MasterRemote only stops resending a Honda start command once it sees the reported running state match the desired one (§10); with SlaveHonda permanently reporting false, Master kept resending every `HONDA_RESTART_BLOCK_MS` (30 s) forever, and each resend — since SlaveHonda also genuinely showed not-running-and-not-starting between cycles — spawned a brand new crank sequence on the already-running engine. Fixed by (1) removing `send_status()`'s `g_honda_running = false` line entirely — it no longer touches that variable, only reports whatever `honda_start()`/`honda_stop()` last set — and (2) changing `honda_start()`'s post-sequence value from `false` to `true` on the non-aborted completion path: since GPIO15 still can't measure the real state (§2.3/v1.30), this assumes success rather than failure, because a false *positive* here only costs an unretried failed start (recoverable with a manual Stop then Start), while a false *negative* was actively re-engaging the starter motor on a running engine — the more dangerous failure mode by far. `honda_stop()` is unchanged (still correctly sets `g_honda_running = false` on every stop, aborted or explicit). SlaveHonda-only (1.3.7); no data-model or wire-format change. **Deployed and verified live within minutes of discovery** — see §10/§12.
- v1.30 — A new SlaveHonda unit was deployed (§2.3), whose GPIO15 (running feedback) is not yet wired to a physical sensor. Confirmed live: with the generator and ignition genuinely off, the unit still reported `running:true` — the pin has no pull resistor configured (by design, meant to be actively driven by a real feedback sensor) and floats to a false-positive reading when unconnected. This isn't just a display bug: MasterRemote's Honda send gate only fires on a mismatch between `g_honda_start_cmd` and the slave's last-known running state, so a false "already running" reading would silently prevent a genuine start command from ever being sent — the same failure shape as the v1.17 force-send bug, but from the opposite direction (a false positive suppressing a real send, rather than a stale equal-state swallowing a manual press). Fixed by hardcoding `g_honda_running = false` at both sites that previously read the pin (`honda_start()`'s post-crank check, `send_status()`), and having `/api/status`'s `run` field report `g_honda_running` instead of independently re-reading the pin, so there's a single source of truth. GPIO15 is still configured as an input (harmless) but no longer trusted for any command or status logic. SlaveHonda-only (1.3.6); no data-model or wire-format change. **When GPIO15 is wired to a real sensor on this unit, both hardcoded-false sites need to be reverted to `!gpio_get_level(PIN_RUNNING_FB)`** (see the code comments at each site).
- v1.29 — Replaced the physical MasterRemote unit with a new board (§2.2), which changed the Wallas GPIO wiring: **GPIO4 (Wallas Start / Victron relay) is now active-LOW** (opposite of the old board and opposite of GPIO15's Honda relay input, which stayed active-HIGH), and **GPIO5 (Wallas Manual Start) is now permanently unwired/obsolete** — the physical manual button was removed from this installation and will not be reinstated. Before this fix, `g_wallas_start_cmd` read GPIO4 non-inverted (backwards — idle read as "start demanded" and vice versa) and still OR'd in GPIO5's now-floating, unpredictable reading as a live command source, which could assert a start with no real input driving it. Fixed all four recompute sites (`isr_wallas_recompute`, `gpio_init()`'s boot-time read, `timer_task`, `h_wallas_stop`) to invert GPIO4 and drop GPIO5 from the command entirely; the ISR service no longer attaches a handler to GPIO5 (still configured as a pulled-up input so it doesn't float wildly at the electrical level, just doesn't drive anything). `/api/status`'s `pWS` field now reports the corrected (inverted) reading; `pWM` still reports GPIO5's raw level for diagnostics but is labeled "unused" in the UI. Verified live against the physical Victron relay both ON and OFF before and after the fix. MasterRemote-only (1.5.7); no data-model or wire-format change. See §2.2/§10. Full-codebase review pass; six fixes, two of them serious. **(1) SlaveHonda crashed (panic + reboot) at the end of every start sequence:** `honda_start()` was spawned via `xTaskCreate` but *returned* when the sequence finished — a FreeRTOS task function must never return, so ESP-IDF aborted the whole unit ~14 s after each start command, dropping the ignition relay of the generator it had just started. Now wrapped in a proper task (`honda_start_task`) that self-deletes. **(2) A stop command during the start sequence didn't cancel it:** the 10 s warm-up and 3 s crank were single blocking delays that never re-checked `g_start_cmd`, so a stop mid-warm-up still cranked the starter for 3 s afterwards. The delays now poll `g_start_cmd` in 100 ms steps and abort promptly. Ownership of `g_honda_starting` moved to the sequence task itself (claimed by the spawner *before* task creation, cleared only by the task on exit), which also closes two duplicate-sequence races: `honda_stop()` clearing the flag mid-sequence, and Master's redundant 20 ms double-send spawning two tasks. **(3) MasterRemote's GPIO ISRs each recomputed the command from a subset of sources** — the third occurrence of the §12 OR-recompute bug class: e.g. releasing the Honda manual button recomputed `g_honda_start_cmd` *without* the Victron relay term, shutting down a generator the Victron still demanded (and unlike Wallas, Honda has no periodic recompute to self-heal). Replaced the four per-pin ISRs with two per-command ISRs (`isr_honda_recompute`/`isr_wallas_recompute`), each ORing ALL of its command's sources, attached to every input pin that feeds that command; boot-time initial reads now use the same full expressions. **(4) MasterRemote reconnect churn in portal mode:** its WiFi event handler lacked the `!g_portal_mode` guard both slaves have, so the portal's APSTA start kept retrying the failed STA credentials while the user was configuring. **(5) `/api/sysinfo` reported a garbage `heapMin`** (the `UINT32_MAX` sentinel, ~4 GB) during the first 10 s sampling interval after slave boot — `status_task` now takes a baseline sample immediately at task start. **(6) The WiFi portal saved URL-encoded credentials verbatim:** a password/SSID containing a space, `+`, `&`, or any `%XX`-encoded symbol was stored in encoded form, rebooting the unit into a connect-fail/portal loop; `h_wifi_save` now URL-decodes both fields on all three units. Also hardened `h_root` to check `esp_netif_get_ip_info()`'s return before formatting the header IP. Two review findings deliberately accepted as-is: unlocked cross-task reads of roster strings (worst case a momentarily torn string in JSON, harmless), and `/api/timer/set` treating missing query keys as 00:00 (only called by our own UI, which always sends all keys). MasterRemote 1.5.6, SlaveHonda 1.3.5, SlaveWallas 1.5.6; no data-model or wire-format change.
- v1.27 — Fixed a silent OTA-breaking bug on SlaveHonda: `httpd_config_t.max_uri_handlers` was hardcoded to `8`, exactly matching the route count *before* v1.25/v1.26 added `/api/sysinfo` — the 9th route pushed `/ota/upload` (last in the registration array) past the cap, and since the registration loop never checked `httpd_register_uri_handler()`'s return value, it failed *silently*: the server started fine, every other route worked, and only `/ota/upload` 404'd, with no log line pointing at the cause. Discovered when a routine OTA deploy of v1.10.0 failed against SlaveHonda with an immediate HTTP 404. SlaveWallas and MasterRemote turned out to have the identical fragility — both were sized to *exactly* their current route count (`9` and `14` respectively) with zero headroom, meaning either would have silently broken the same way the next time a route was added, with no warning. Fixed by (1) giving all three units headroom above their current route count (SlaveHonda/SlaveWallas → 16, MasterRemote → 22) and (2) having the registration loop log `ESP_LOGE` on any individual handler registration failure, so this class of bug is loud instead of silent from now on. MasterRemote 1.5.5, SlaveHonda 1.3.4, SlaveWallas 1.5.5; no data-model or wire-format change.
- v1.26 — Two follow-ups to the v1.25 System resource monitor and Debug GPIO tab. (1) `heapMin` previously came straight from `esp_get_minimum_free_heap_size()`, which is exact but has no notion of *when* that minimum happened — useless for telling "dipped once at boot, flat ever since" apart from "actively still dropping". Replaced with a self-sampled low-water mark (`g_heap_min`/`g_heap_min_ts_us` in `main.c`, updated in each unit's existing periodic task — `status_task` on the slaves, `timer_task` on MasterRemote) paired with a timestamp, so the value and its age are always consistent. New `heapMinAgo` field on `/api/sysinfo`; the System card now shows e.g. "180 KB — 2h 14m ago". Trades IDF's byte-exact tracking for a periodic sample (10 s slaves / 20 s Master) — an acceptable approximation for spotting a slow leak, which is the only thing this field is for. (2) Fixed the Debug GPIO tab's "GPIOnn : ●" status dot sitting visibly below the text's vertical center — `vertical-align:middle` on an inline `<span>` aligns to a font-metric-dependent point that doesn't reliably match a 12px circle against arbitrary text. Replaced with `display:inline-flex;align-items:center` on the row's label span, the same flexbox-based approach already used for row alignment elsewhere in this UI, so centering no longer depends on font metrics. SlaveHonda/SlaveWallas only (no Debug GPIO tab on MasterRemote). MasterRemote 1.5.4, SlaveHonda 1.3.3, SlaveWallas 1.5.4; no data-model or wire-format change.
- v1.25 — Fixed a severe bug where all three units' web servers (and IP-based access generally) would permanently die after an extended runtime following any transient WiFi hiccup (router reboot, brief outage, interference). `wifi_event_handler`'s `WIFI_EVENT_STA_DISCONNECTED` case capped reconnect attempts at `MAX_RETRY` (5) and then gave up forever, setting a `WIFI_FAIL_BIT` nobody was listening for post-boot — that event group wait only happens once, during the initial `wifi_init_and_connect()` boot sequence. Once exhausted, no code path ever called `esp_wifi_connect()` again, so the STA stayed permanently disconnected until a manual power cycle. ESP-NOW kept working throughout (it operates at the radio layer, independent of STA/AP association), which is why heartbeats and commands stayed up even as the web UI became unreachable and the Nodes tab showed a slave with no IP (`get_ip_str()`/the heartbeat's `ip` field both go empty once the netif has no address). Reported after MasterRemote needed a manual power cycle to recover; SlaveHonda and SlaveWallas were unreachable at the same time, consistent with one shared WiFi outage tripping the same latent bug on all three. Fixed by latching whether the STA has ever connected since boot (`s_wifi_ever_connected`, set on the first `IP_EVENT_STA_GOT_IP`): once true, `WIFI_EVENT_STA_DISCONNECTED` retries indefinitely instead of giving up after 5 tries — the retry cap now only governs the initial boot decision to fall back to the config portal, never a later in-service disconnect. Identical fix applied to MasterRemote (1.5.3), SlaveHonda (1.3.2), SlaveWallas (1.5.3); no data-model or wire-format change. Also added a **System** resource monitor (free heap, heap low-water mark, uptime, WiFi reconnect count) to each unit's own web UI, so a slow resource leak can be caught before it causes an outage like this one — the low-water mark (`esp_get_minimum_free_heap_size()`) is the reliable leak signal, since it survives momentary recoveries that a plain "current free heap" reading would hide. New `GET /api/sysinfo` endpoint on all three units; surfaced in SlaveHonda's/SlaveWallas's Debug GPIO tab and MasterRemote's Pin Status tab (Master has no Debug GPIO tab). A new `g_wifi_disconnect_count` counter (never reset) tracks total STA disconnects since boot, useful for judging how flaky a given unit's WiFi link actually is.
- v1.24 — Fixed the Debug GPIO tab's live-level dot (v1.23) being genuinely invisible, not just hard to see: the dot is a `<span class="led">`, but `.led`'s CSS only set `width`/`height`/`border-radius` — properties a `<span>` (inline by default) silently ignores. Added `display:inline-block` (plus `vertical-align:middle`) to `.led` so the dot actually renders wherever it's used, span or div. This was a pre-existing bug, not introduced by v1.23's reorder — it just made the missing dot more noticeable once it was no longer buried in front of bold text. SlaveHonda has the identical Debug GPIO tab code and the same bug, so it received the same two fixes (CSS + "GPIOnn : ●" reorder) for parity. SlaveWallas v1.5.2, SlaveHonda v1.3.1; no data-model or API change.
- v1.23 — Debug GPIO tab (SlaveWallas): each pin row's live-level dot was easy to miss, sitting inline in front of the bold, centered "GPIOnn" label. Reformatted to "GPIOnn : ●" (label first, dot trailing after the colon) so the indicator reads clearly; the ON/OFF control buttons remain on their own line below, unchanged. SlaveWallas-only, web UI change (v1.5.1), no data-model or API change.
- v1.22 — Weekly Timer tab UX: editing a day's enabled/start/stop no longer saves per-field on every change. All 7 rows now stage locally and a single **Set** button (disabled until something is edited) commits all changed rows at once with one click, then re-disables. Avoids a stray keystroke or checkbox click silently firing a save mid-edit. MasterRemote-only, web UI change (v1.5.2), no data-model or API change.
- v1.21 — Fixed the weekly Wallas timer (v1.20) never actually activating: `timer_task` set `g_timer_wallas_start` every tick, but nothing recomputed `g_wallas_start_cmd` from it outside of a GPIO edge or a web button click — a plain clock tick reaching a schedule boundary was neither. Same class of bug as the Honda force-send fix (§12): setting an OR-source flag isn't enough if nothing re-evaluates the combined command. `timer_task` now recomputes `g_wallas_start_cmd` directly every tick. Caught immediately during live testing (the "1.5.0" build silently never turned the heater on for an active window). MasterRemote-only fix (v1.5.1).
- v1.20 — Added an NTP clock and weekly Wallas timer to MasterRemote (§3.2, §6.1). MasterRemote syncs time via SNTP (`pool.ntp.org`) in the CET/CEST timezone (`Europe/Oslo`, auto-DST). A new **Weekly Timer** tab lets each day of the week be independently enabled/disabled with a start `HH:MM` and stop `HH:MM`, persisted in NVS. The timer is a fourth Wallas command source, OR'd in alongside the Victron relay, physical manual button, and web override — active whenever today is enabled and the current local time falls in `[start, stop)` (a window crossing midnight, e.g. 22:00–02:00, is handled correctly). Never activates before the clock has completed its first sync (guarded by a sanity floor, so an un-synced ~1970 clock can't produce a false match). MasterRemote-only change (v1.5.0) — no slave firmware changes needed.
- v1.19 — Hardened command authenticity (§3.2/§12): previously, a slave accepted a `master_msg_t` start/stop command from **any** ESP-NOW sender of the right message size — the source MAC was never checked. Slaves now only act on commands from the exact MAC they registered as Master via the beacon, and reject a *new* beacon claimant while their current Master is still active (`MASTER_STALE_US` = 30 s) rather than blindly re-homing trust — closing the "spoof a beacon first, then send commands from that MAC" loophole. Symmetrically, MasterRemote's `register_peer()` now refuses to hand a slave role (SlaveHonda/SlaveWallas) to a new MAC while the current holder is still within the node-stale timeout, so a rogue sender can't hijack a role and feed Master false status. This is MAC-address verification, not cryptographic authentication — it stops stray/accidental ESP-NOW traffic and casual spoofing, not a determined attacker who deliberately clones a MAC. Full protection against that would need ESP-NOW's per-peer encryption (`peer.encrypt`/LMK), which remains available but unused — see §12. All three units updated (MasterRemote 1.4.0, SlaveHonda 1.3.0, SlaveWallas 1.5.0); no wire-format change, so this can be deployed to any subset first without breaking compatibility with not-yet-updated units.
- v1.18 — SlaveHonda's onboard LED (GPIO2) now matches SlaveWallas's blink pattern: fast (200 ms half-period) when start commanded by Master (`g_start_cmd`), slow (1 s half-period) when idle — previously a fixed 1 Hz blink regardless of state. SlaveHonda-only fix (v1.2.2), no MasterRemote/SlaveWallas changes needed.
- v1.17 — Fixed the manual **Start/Stop Honda** web buttons (§6.1) silently doing nothing in some cases. `master_task`'s Honda send is edge-triggered — it only transmits when `g_honda_start_cmd != g_slave_honda_running` (Master's last-known feedback from the slave), unlike Wallas which just resends every 15 s unconditionally. If that last-known state already happened to equal the button's target state (e.g. an unconnected/floating running-feedback sensor reading as permanently "running"), the mismatch check was never true and the command never went out. Added `g_honda_force_send`, set by both `/api/honda/start` and `/api/honda/stop`, which forces one send on the next `master_task` tick regardless of the mismatch check or the 30 s restart-block cooldown, then clears itself. MasterRemote-only fix (v1.3.1) — no slave firmware changes needed.
- v1.16 — CI release notes now list each unit's name and version as its own line (e.g. "**MasterRemote** v1.3.0"), derived automatically from the downloaded artifact filenames in the `release` job — no changes needed to the per-unit build jobs. See §8.
- v1.15 — Cleaned up the 18 old per-unit GitHub Releases (`master-v*`/`honda-v*`/`wallas-v*`) left over from before the release reorg in v1.13 — each was a single-binary release that cluttered the Releases page and risked someone downloading a stale, possibly protocol-incompatible `.bin` by mistake. Deleted the *releases* (and their uploaded binaries) but kept the underlying *git tags* — no history was lost, `git checkout <tag>` still works for all of them. `v1.5.0` is now the only entry on the Releases page. No firmware or doc content changed.
- v1.14 — Renamed the master unit from **MasterHonda** to **MasterRemote** throughout: project directory (`MasterHonda/` → `MasterRemote/`, git history preserved via `git mv`), `FIRMWARE_NAME`, config-portal AP SSID (`MasterRemote-Config`), CMake project name, HTML page title/header, and every mention in this document, the README, and CI workflow. `NVS_NAMESPACE` was deliberately left as `"mhonda"` so the already-deployed unit keeps its stored WiFi credentials across the update. **Breaking change**: the discovery beacon's identity string changed length (`"MasterHonda"` = 11 chars → `"MasterRemote"` = 12 chars) and both slaves' `strncmp()` match against it — all three units must be reflashed together, or SlaveHonda/SlaveWallas will stop recognizing the beacon and lose discovery. Historical changelog entries below still say "MasterHonda" for the versions where that was the current name.
- v1.13 — Reorganized releases: introduced a release-level version, independent of each unit's own `FIRMWARE_VERSION` (which keep incrementing independently per unit, unchanged by this reorg). All three units are now released together under one combined git tag/GitHub Release at the release version (e.g. `v1.5.0`) instead of separate `master-v*`/`honda-v*`/`wallas-v*` tags — the CI workflow already supported this (a `v*` tag builds all three and attaches all three `.bin` files, each still named with its own unit's version, to one GitHub Release); the per-unit tag patterns just hadn't been in active use this session. Per-unit tags remain available in CI for a genuine single-unit hotfix, but `v*` is now the standard release path. See §8.
- v1.12 — SlaveHonda gains a Debug GPIO tab, mirroring SlaveWallas's (same `GET /api/gpio/set`/`GET /api/gpio/status` design), adapted for the ESP32-classic pin map: manipulable subset is GPIO 4,13,14,16-19,21-23,25-27,32,33; reserved-and-status-only covers strapping (0,2,5,12,15), embedded flash (6-11), UART0 console (1,3), and input-only pins (34-39). Status dots cover the full GPIO 0-39 range. SlaveWallas's regular Status tab gains a lamp-style row for the GPIO23 heater indicator LED (was previously only visible via the Debug tab, not the normal status view).
- v1.11 — SlaveWallas Debug GPIO tab now shows a live status dot (green = HIGH) for every GPIO 0-30, not just the manipulable subset, via a new read-only `GET /api/gpio/status`. Reserved pins (strapping, USB-JTAG) show status only, no ON/OFF buttons, since `gpio_get_level()` alone is passive (just reads the input register) and safe to call on any pin, unlike `h_gpio_set`'s active reconfiguration.
- v1.10 — SlaveWallas: the onboard status LED (GPIO2) blink speed is now keyed off `g_start_cmd` (start commanded by Master) instead of `g_wallas_running` (the running-feedback sensor on GPIO18) — the feedback sensor isn't wired up on this unit yet, so blink speed previously couldn't reflect anything meaningful.
- v1.9 — SlaveWallas: corrected heater relay pin, GPIO16 → GPIO19 (matches actual wiring, confirmed via the Debug GPIO tab added in v1.8). GPIO2 confirmed as the onboard status/heartbeat LED (blinks by design — slow when idle, fast when the heater is running; no change needed there).
- v1.8 — SlaveWallas: corrected stale pin labels on the Status tab (relay was still labeled "p0" after the GPIO0→16 move, feedback still labeled "p13" after the GPIO13→18 move — display-only, the underlying GPIO defines were already correct). Added a **Debug GPIO** tab: `GET /api/gpio/set?pin=N&level=0|1` reconfigures any non-reserved GPIO (0,1,2,3,6,7,10,11,14,16-23; strapping pins 4/5/8/9/15 and USB-JTAG 12/13 excluded) to OUTPUT and drives it, for hardware bring-up when physical pin wiring is uncertain. Overrides normal operation of that pin until reboot — hardware debug only, not for production use.
- v1.7 — Fixed a heap buffer overflow in `h_root()` on all three units: the `%IP%` template placeholder (4 chars) was replaced in-place via `memmove`/`memcpy` inside a buffer sized only for the original template (`strdup()`), so any IP string longer than 4 characters (i.e. almost any real IP) overflowed the allocation, corrupting the heap and crashing the device shortly after — usually visible as the TCP connection to `/` resetting mid-response, while smaller endpoints like `/api/status` kept working fine. Rewritten to build the substituted page into a freshly, exactly-sized buffer instead of mutating a fixed-size one in place. Discovered because SlaveHonda's root page happened to work (no WiFi IP → 1-char `"?"` placeholder, which shrinks rather than overflows) while SlaveWallas's (a real IP) reliably crashed on load.
- v1.6 — Slave heartbeats (`slave_msg_t`/`slave_wallas_msg_t`) now carry per-link RSSI, channel, and firmware version, sourced from the receiving radio's `rx_ctrl` on the last frame heard from MasterRemote (works whether or not the slave has its own WiFi/AP association). MasterRemote's Nodes tab is redesigned as a table (one row per node, RSSI/Channel/FW columns) instead of stacked cards, and the Pin Status tab gains manual **Start/Stop Honda** and **Start/Stop Wallas** buttons — a third command source OR'd in alongside the Victron relay and physical manual buttons via new `/api/honda/start\|stop` and `/api/wallas/start\|stop` endpoints. **Breaking change** (message struct sizes changed) — all three units must be upgraded together, same as §3.2.
- v1.5 — Fixed an OTA upload bug on all three units: `h_ota_upload()` retried `httpd_req_recv()` forever on a timeout instead of giving up, so a client aborting mid-upload could permanently wedge the httpd worker (and, since there's only one, the entire web server) until a USB reflash. Now bounded to 5 consecutive timeouts before aborting cleanly. SlaveWallas: moved `PIN_WALLAS_FB` off GPIO13 (reserved for native USB-Serial/JTAG D+, §2.4) to GPIO18.
- v1.4 — SlaveWallas: fixed heater relay pin (GPIO0 → GPIO16, matches actual wiring); added a GPIO23 indicator LED that mirrors the relay output for hardware-level confirmation. MasterRemote: added WiFi signal strength (RSSI) and channel to the Pin Status tab / `/api/status`
- v1.3 — Removed custom MAC addressing; units now self-discover peers by function role over ESP-NOW. SlaveHonda gains a WiFi-optional fallback (ESP-NOW channel scan for MasterRemote when it cannot reach the router). MasterRemote's Clients tab becomes a Nodes tab (MAC, IP, connected status, last seen). **Breaking change** — see §3.2 and §12.
- v1.2 — Migrated firmware and CI to ESP-IDF v6.0.1; SlaveWallas moved to ESP32-C6; added WiFi network scan to the config portal
- v1.1 — Converted firmware framework from Arduino to ESP-IDF v5
