SEspe/RemoteStart/MasterRemote/main/main.c

/*
 * MasterRemote — ESP32 Master Remote Start Controller
 * Author: SEspe
 * Framework: ESP-IDF v6.x
 *
 * Build:  idf.py build
 * Flash:  idf.py -p COMx flash monitor
 * OTA:    http://<device-ip>/ota  (after first WiFi setup)
 *
 * First startup: connect to "MasterRemote-Config" WiFi (pw: honda1234),
 *   open 192.168.4.1, enter your router credentials.
 *
 * Peer discovery: no custom/hardcoded MAC addresses. Each unit uses its own
 * factory MAC. MasterRemote broadcasts a beacon; slaves that hear it learn
 * Master's MAC and register themselves via their normal heartbeat — see
 * FSD_RemoteStart.md §3.2.
 */

#include <stdio.h>
#include <string.h>
#include <stdbool.h>
#include <stdint.h>
#include <time.h>

#include "freertos/FreeRTOS.h"
#include "freertos/task.h"
#include "freertos/event_groups.h"

#include "esp_system.h"
#include "esp_log.h"
#include "esp_wifi.h"
#include "esp_event.h"
#include "esp_now.h"
#include "esp_netif.h"
#include "mdns.h"
#include "esp_netif_sntp.h"
#include "esp_mac.h"
#include "esp_timer.h"
#include "nvs_flash.h"
#include "nvs.h"
#include "driver/gpio.h"

#include "version.h"
#include "web_server.h"

static const char *TAG = FIRMWARE_NAME;

/* ── Peer Discovery ────────────────────────────────────────────────────────── */
static const uint8_t BROADCAST_MAC[] = {0xFF,0xFF,0xFF,0xFF,0xFF,0xFF};
#define BEACON_INTERVAL_MS   2000
#define NODE_TIMEOUT_MS      30000

/* ── Pin Definitions ───────────────────────────────────────────────────────── */
#define PIN_HONDA_STARTED_FB     GPIO_NUM_13   /* Output: Honda running LED   */
#define PIN_STATUS_LED           GPIO_NUM_2    /* Output: onboard heartbeat   */
#define PIN_HONDA_START          GPIO_NUM_15   /* Input:  Victron relay       */
#define PIN_HONDA_MANUAL_START   GPIO_NUM_14   /* Input:  manual push (PU)    */
#define PIN_WALLAS_START         GPIO_NUM_4    /* Input:  Victron relay       */
#define PIN_WALLAS_MANUAL_START  GPIO_NUM_5    /* Input:  manual switch (PU)  */

/* ── Timing (ms) ───────────────────────────────────────────────────────────── */
#define HONDA_RESTART_BLOCK_MS   30000
#define WALLAS_SEND_INTERVAL_MS  15000

/* ── Message Structures (shared with slaves — see FSD §3.3) ───────────────── */
typedef struct {
    char  label[32];
    bool  HondaRunningFB;
    bool  HondaIgnitionOn;
    bool  HondaStart;
} master_msg_t;

typedef struct {
    char  label[32];   /* "MasterRemote" */
} master_beacon_t;      /* broadcast-only, discovery */

typedef struct {
    char  label[32];
    bool  HondaIgnitionOn;
    bool  HondaStarting;
    bool  HondaRunning;
    char  ip[16];
    bool  has_wifi;
    int8_t  rssi;
    uint8_t channel;
    char    fw_version[12];
} slave_honda_msg_t;

typedef struct {
    char  label[32];
    bool  WallasRunning;
    bool  WallasStart;
    char  ip[16];
    bool  has_wifi;
    int8_t  rssi;
    uint8_t channel;
    char    fw_version[12];
} slave_wallas_msg_t;

/* Weekly-timer sync and SlaveWallas's Start/Stop buttons (v1.56). Packed so
 * the ESP32 and ESP32-C6 builds agree byte for byte. Every unit tells message
 * types apart by length, so these sizes (71, 33) must stay distinct from the
 * others (32, 35, 65, 66) -- ESPNowRelay relies on that too. */
typedef struct __attribute__((packed)) {
    char     label[32];     /* "Master->WallasTimer" or "SlaveWallas->Timer" */
    uint32_t rev;           /* last-edit-wins: the higher rev is kept by both */
    uint8_t  day[7][5];     /* enabled, start hh, start mm, stop hh, stop mm; [0] = Sunday */
} wallas_timer_msg_t;
_Static_assert(sizeof(wallas_timer_msg_t) == 71, "wallas_timer_msg_t wire size");

typedef struct __attribute__((packed)) {
    char    label[32];      /* "SlaveWallas->WebCmd" */
    uint8_t start;          /* 1 = Start Wallas pressed, 0 = Stop Wallas */
} wallas_webcmd_msg_t;
_Static_assert(sizeof(wallas_webcmd_msg_t) == 33, "wallas_webcmd_msg_t wire size");

#define TIMER_SYNC_INTERVAL_US  ((int64_t)60 * 1000000)

/* ── Global State (written from ISR + read from task) ──────────────────────── */
volatile bool g_honda_start_cmd  = false;
volatile bool g_wallas_start_cmd = false;
         bool g_slave_honda_running = false;

/* Web UI manual-start override — a third source OR'd in alongside the Victron
 * relay and physical manual button. Set/cleared by web_server.c's
 * /api/honda/start|stop and /api/wallas/start|stop handlers. */
volatile bool g_web_honda_start  = false;
volatile bool g_web_wallas_start = false;

/* Set by the web handlers on every manual button press. Honda's normal send
 * gate only fires on a MISMATCH between g_honda_start_cmd and Master's last
 * -known slave running state -- if that state happens to already equal the
 * new command (e.g. a stale/unconnected running-feedback pin reading as
 * "running"), a manual press would otherwise be silently swallowed. This
 * flag forces one send regardless, bypassing both the mismatch check and
 * the restart-block cooldown, then clears itself. */
volatile bool g_honda_force_send = false;

/* Sends the Wallas command now instead of at the next WALLAS_SEND_INTERVAL_MS
 * tick -- set when SlaveWallas (re)registers or presses a button there. */
volatile bool g_wallas_force_send = false;

/* Self-sampled heap low-water mark, paired with a timestamp -- esp_get_minimum_free_heap_size()
 * tracks the exact minimum but has no "when", so this is sampled alongside it in timer_task's
 * 20 s tick to keep the reported value and its age self-consistent. */
uint32_t g_heap_min       = UINT32_MAX;
int64_t  g_heap_min_ts_us = 0;

/* ── NTP Clock & Weekly Wallas Timer ────────────────────────────────────────── */
/* Fourth Wallas command source, OR'd in alongside the Victron relay, physical
 * manual button, and web override. True whenever today's timer is enabled and
 * the current local time falls within [start, stop). Only ever trusted once
 * the clock has synced (see NTP_MIN_VALID_EPOCH) -- see FSD §3.2/§12. */
volatile bool g_timer_wallas_start = false;

/* ── Physical input enable mask ─────────────────────────────────────────────
 * One bit per GPIO command source; a cleared bit makes that pin contribute
 * nothing to its command, whatever level it reads. For a unit with an input
 * left unwired (a test bench, or a switch not fitted) -- an open manual-switch
 * input reads as "On" by design of the wiring (§2.2). All enabled by default;
 * persisted as NVS u8 "inen". Web/timer sources are not maskable here. */
#define IN_EN_HONDA_START    (1u << 0)   /* GPIO15, Victron relay  */
#define IN_EN_HONDA_MANUAL   (1u << 1)   /* GPIO14, manual switch  */
#define IN_EN_WALLAS_START   (1u << 2)   /* GPIO4,  Victron relay  */
#define IN_EN_WALLAS_MANUAL  (1u << 3)   /* GPIO5,  manual switch  */
#define IN_EN_ALL            0x0Fu
volatile uint8_t g_input_enable = IN_EN_ALL;

/* The one place each combined command is computed: every recompute site (both
 * ISRs, gpio_init's boot read, timer_task, the web stop handlers, an enable-
 * mask change) calls these, so the OR of all sources can't drift between
 * sites again (§3.2 recompute bug class). IRAM because the ISRs call them.
 * GPIO15/GPIO4 are active LOW (opto open collector); GPIO14/GPIO5 read
 * non-inverted (the switch grounds the pin when Off). */
bool IRAM_ATTR honda_cmd_compute(void)
{
    uint8_t en = g_input_enable;
    return ((en & IN_EN_HONDA_START)  && !gpio_get_level(PIN_HONDA_START)) ||
           ((en & IN_EN_HONDA_MANUAL) &&  gpio_get_level(PIN_HONDA_MANUAL_START)) ||
           g_web_honda_start;
}

bool IRAM_ATTR wallas_cmd_compute(void)
{
    uint8_t en = g_input_enable;
    return ((en & IN_EN_WALLAS_START)  && !gpio_get_level(PIN_WALLAS_START)) ||
           ((en & IN_EN_WALLAS_MANUAL) &&  gpio_get_level(PIN_WALLAS_MANUAL_START)) ||
           g_web_wallas_start || g_timer_wallas_start;
}

static void input_enable_load(void)
{
    nvs_handle_t h;
    if (nvs_open(NVS_NAMESPACE, NVS_READONLY, &h) != ESP_OK) return;   /* keep default: all enabled */
    uint8_t v = IN_EN_ALL;
    if (nvs_get_u8(h, "inen", &v) == ESP_OK) g_input_enable = v & IN_EN_ALL;
    nvs_close(h);
}

/* Called by web_server.c's /api/inputs/set. Saves, then recomputes both
 * commands at once so a disabled pin's demand drops without waiting for a
 * GPIO edge; a Honda change is force-sent, as the web stop button does. */
void input_enable_set(uint8_t mask)
{
    g_input_enable = mask & IN_EN_ALL;
    nvs_handle_t h;
    if (nvs_open(NVS_NAMESPACE, NVS_READWRITE, &h) == ESP_OK) {
        nvs_set_u8(h, "inen", g_input_enable);
        nvs_commit(h);
        nvs_close(h);
    }
    bool honda = honda_cmd_compute();
    if (honda != g_honda_start_cmd) {
        g_honda_start_cmd  = honda;
        g_honda_force_send = true;
    }
    g_wallas_start_cmd = wallas_cmd_compute();
}

#define NTP_MIN_VALID_EPOCH  1704067200   /* 2024-01-01 UTC -- sanity floor so an
                                            * unsynced clock (epoch ~1970) can never
                                            * be mistaken for a real time-of-day match */
#define WALLAS_TZ  "CET-1CEST,M3.5.0,M10.5.0/3"   /* Europe/Oslo, auto DST */

typedef struct {
    bool    enabled;
    uint8_t start_hh, start_mm;
    uint8_t stop_hh,  stop_mm;
} day_timer_t;

/* Index 0 = Sunday .. 6 = Saturday, matching struct tm.tm_wday directly. */
static day_timer_t s_wallas_timer[7] = {0};
static bool        s_ntp_synced      = false;

/* Revision of the timer table, shared with SlaveWallas (v1.56): every local
 * edit raises it, and on contact both units keep the table with the higher
 * rev. See timer_next_rev(). */
static uint32_t s_timer_rev = 0;

static void timer_nvs_load(void)
{
    nvs_handle_t h;
    if (nvs_open(NVS_NAMESPACE, NVS_READONLY, &h) != ESP_OK) return;
    size_t sz = sizeof(s_wallas_timer);
    bool have_table = nvs_get_blob(h, "walltimer", s_wallas_timer, &sz) == ESP_OK;   /* leaves defaults (all disabled) if absent */
    /* A table saved before v1.56 has no rev; give it 1 so it outranks a
     * never-edited SlaveWallas (rev 0) and gets copied there. */
    if (nvs_get_u32(h, "walltrev", &s_timer_rev) != ESP_OK) s_timer_rev = have_table ? 1 : 0;
    nvs_close(h);
}

static void timer_nvs_save(void)
{
    nvs_handle_t h;
    if (nvs_open(NVS_NAMESPACE, NVS_READWRITE, &h) != ESP_OK) return;
    nvs_set_blob(h, "walltimer", s_wallas_timer, sizeof(s_wallas_timer));
    nvs_set_u32(h, "walltrev", s_timer_rev);
    nvs_commit(h);
    nvs_close(h);
}

/* The wall-clock time of the edit once NTP has synced, so "last edit wins"
 * holds across the two units; never lower than the current rev + 1, so it
 * still rises before sync or within the same second. */
static uint32_t timer_next_rev(void)
{
    uint32_t now = (uint32_t)time(NULL);
    return (now >= 1704067200u && now > s_timer_rev) ? now : s_timer_rev + 1;
}

/* ── Timer sync with SlaveWallas over ESP-NOW (v1.56) ─────────────────────── */
static volatile int64_t   s_timer_sync_due_us = 0;      /* next send; 0 = now */
static wallas_timer_msg_t s_timer_in;                   /* received, applied by master_task */
static volatile bool      s_timer_in_pending  = false;

static void timer_fill_msg(wallas_timer_msg_t *m)
{
    memset(m, 0, sizeof(*m));
    strlcpy(m->label, "Master->WallasTimer", sizeof(m->label));
    m->rev = s_timer_rev;
    for (int d = 0; d < 7; d++) {
        m->day[d][0] = s_wallas_timer[d].enabled ? 1 : 0;
        m->day[d][1] = s_wallas_timer[d].start_hh; m->day[d][2] = s_wallas_timer[d].start_mm;
        m->day[d][3] = s_wallas_timer[d].stop_hh;  m->day[d][4] = s_wallas_timer[d].stop_mm;
    }
}

/* Adopts a received table if it is newer; a wholly invalid day is skipped
 * rather than trusted. Returns true if adopted. */
static bool timer_apply_msg(const wallas_timer_msg_t *m)
{
    if (m->rev <= s_timer_rev) return false;
    for (int d = 0; d < 7; d++) {
        const uint8_t *x = m->day[d];
        if (x[1] > 23 || x[2] > 59 || x[3] > 23 || x[4] > 59) continue;
        s_wallas_timer[d].enabled  = x[0] != 0;
        s_wallas_timer[d].start_hh = x[1]; s_wallas_timer[d].start_mm = x[2];
        s_wallas_timer[d].stop_hh  = x[3]; s_wallas_timer[d].stop_mm  = x[4];
    }
    s_timer_rev = m->rev;
    timer_nvs_save();
    return true;
}

/* ── Timer accessors for web_server.c (function interface, not shared struct
 * layout, so the two files never need to be kept byte-for-byte in sync) ──── */
void timer_get_day(int day, bool *enabled, int *start_hh, int *start_mm, int *stop_hh, int *stop_mm)
{
    if (day < 0 || day > 6) { *enabled = false; *start_hh = *start_mm = *stop_hh = *stop_mm = 0; return; }
    const day_timer_t *d = &s_wallas_timer[day];
    *enabled  = d->enabled;
    *start_hh = d->start_hh; *start_mm = d->start_mm;
    *stop_hh  = d->stop_hh;  *stop_mm  = d->stop_mm;
}

void timer_set_day(int day, bool enabled, int start_hh, int start_mm, int stop_hh, int stop_mm)
{
    if (day < 0 || day > 6) return;
    if (start_hh < 0 || start_hh > 23 || start_mm < 0 || start_mm > 59 ||
        stop_hh  < 0 || stop_hh  > 23 || stop_mm  < 0 || stop_mm  > 59) return;
    day_timer_t *d = &s_wallas_timer[day];
    d->enabled  = enabled;
    d->start_hh = (uint8_t)start_hh; d->start_mm = (uint8_t)start_mm;
    d->stop_hh  = (uint8_t)stop_hh;  d->stop_mm  = (uint8_t)stop_mm;
    s_timer_rev = timer_next_rev();
    timer_nvs_save();
    /* The tab saves all 7 days in a burst; one send a second later carries them all. */
    s_timer_sync_due_us = esp_timer_get_time() + 1000000;
}

uint32_t timer_get_rev(void) { return s_timer_rev; }

bool timer_is_synced(void) { return s_ntp_synced; }

/* Formats the current local time as "YYYY-MM-DD HH:MM:SS" into buf, or
 * "not synced" if NTP hasn't completed yet. */
void timer_get_now_str(char *buf, size_t sz)
{
    if (!s_ntp_synced) { snprintf(buf, sz, "not synced"); return; }
    time_t now = time(NULL);
    struct tm tm_now;
    localtime_r(&now, &tm_now);
    strftime(buf, sz, "%Y-%m-%d %H:%M:%S", &tm_now);
}

static void ntp_init(void)
{
    setenv("TZ", WALLAS_TZ, 1);
    tzset();
    esp_sntp_config_t cfg = ESP_NETIF_SNTP_DEFAULT_CONFIG("pool.ntp.org");
    esp_netif_sntp_init(&cfg);
}

/* Recomputes g_timer_wallas_start every tick from the current local day/time
 * against s_wallas_timer. Handles a window that wraps past midnight (e.g.
 * start 22:00, stop 02:00). Never activates before the clock has synced. */
static void timer_task(void *arg)
{
    for (;;) {
        time_t now = time(NULL);
        if (!s_ntp_synced && now >= NTP_MIN_VALID_EPOCH) {
            s_ntp_synced = true;
            ESP_LOGI(TAG, "NTP synced");
        }

        bool active = false;
        if (s_ntp_synced) {
            struct tm tm_now;
            localtime_r(&now, &tm_now);
            const day_timer_t *d = &s_wallas_timer[tm_now.tm_wday];
            if (d->enabled) {
                int cur_min   = tm_now.tm_hour * 60 + tm_now.tm_min;
                int start_min = d->start_hh * 60 + d->start_mm;
                int stop_min  = d->stop_hh  * 60 + d->stop_mm;
                active = (start_min <= stop_min)
                    ? (cur_min >= start_min && cur_min < stop_min)
                    : (cur_min >= start_min || cur_min < stop_min);   /* wraps past midnight */
            }
        }
        g_timer_wallas_start = active;

        /* Setting the flag alone isn't enough -- g_wallas_start_cmd is only
         * recomputed on a GPIO edge or a web button click, neither of which
         * a plain clock tick is. Recompute it here too, or a schedule
         * boundary would silently never take effect (same class of bug as
         * the Honda force-send fix, §12). */
        g_wallas_start_cmd = wallas_cmd_compute();

        uint32_t cur_heap = esp_get_free_heap_size();
        if (cur_heap < g_heap_min) { g_heap_min = cur_heap; g_heap_min_ts_us = esp_timer_get_time(); }

        vTaskDelay(pdMS_TO_TICKS(20000));
    }
}

/* ── Slave Roster (populated dynamically by ESP-NOW recv callback) ─────────── */
typedef struct {
    uint8_t  mac[6];
    bool     peer_added;
    char     ip[16];
    bool     has_wifi;
    int64_t  last_seen_us;
    bool     honda_ign_on;
    bool     honda_starting;
    bool     honda_running;
    bool     wallas_running;
    bool     wallas_start_cmd;
    int8_t   rssi;
    uint8_t  channel;
    char     fw_version[12];
} slave_info_t;

slave_info_t g_slave_honda  = {0};
slave_info_t g_slave_wallas = {0};

/* ── WiFi / provisioning ────────────────────────────────────────────────────── */
#define WIFI_CONNECTED_BIT  BIT0
#define WIFI_FAIL_BIT       BIT1
static EventGroupHandle_t  s_wifi_eg;
static int                 s_retry_count = 0;
static bool                s_wifi_ever_connected = false;
static bool                g_portal_mode = false;
volatile uint32_t          g_wifi_disconnect_count = 0;
volatile int64_t           g_wifi_last_disc_ts_us  = 0;   /* 0 = never disconnected since boot */
#define MAX_RETRY 5

/* ── NVS helpers ────────────────────────────────────────────────────────────── */
static esp_err_t nvs_load_wifi(char *ssid, char *pass, size_t len)
{
    nvs_handle_t h;
    esp_err_t err = nvs_open(NVS_NAMESPACE, NVS_READONLY, &h);
    if (err != ESP_OK) return err;
    size_t sl = len, pl = len;
    err  = nvs_get_str(h, "ssid", ssid, &sl);
    err |= nvs_get_str(h, "pass", pass, &pl);
    nvs_close(h);
    return err;
}

static void nvs_save_wifi(const char *ssid, const char *pass)
{
    nvs_handle_t h;
    if (nvs_open(NVS_NAMESPACE, NVS_READWRITE, &h) == ESP_OK) {
        nvs_set_str(h, "ssid", ssid);
        nvs_set_str(h, "pass", pass);
        nvs_commit(h);
        nvs_close(h);
        ESP_LOGI(TAG, "WiFi credentials saved");
    }
}

/* ── IP configuration (DHCP by default, optional static IP) ──────────────────
 * g_ipcfg_* are the single source of truth: loaded from NVS at boot, read by
 * web_server.c's GET /api/ipconfig, and overwritten in place by POST
 * /api/ipconfig/save before config_apply_task persists + reboots (same
 * save-then-reboot shape as g_new_ssid/g_new_pass above). */
bool          g_ipcfg_static = false;
char          g_ipcfg_ip[16]   = {0};
char          g_ipcfg_mask[16] = {0};
char          g_ipcfg_gw[16]   = {0};
char          g_ipcfg_dns[16]  = {0};
volatile bool g_ipcfg_save_requested = false;

static void nvs_load_ipcfg(void)
{
    nvs_handle_t h;
    if (nvs_open(NVS_NAMESPACE, NVS_READONLY, &h) != ESP_OK) return;
    uint8_t mode = 0;
    nvs_get_u8(h, "ipmode", &mode);
    g_ipcfg_static = (mode == 1);
    size_t l;
    l = sizeof(g_ipcfg_ip);   if (nvs_get_str(h, "ip",   g_ipcfg_ip,   &l) != ESP_OK) g_ipcfg_ip[0]   = '\0';
    l = sizeof(g_ipcfg_mask); if (nvs_get_str(h, "mask", g_ipcfg_mask, &l) != ESP_OK) g_ipcfg_mask[0] = '\0';
    l = sizeof(g_ipcfg_gw);   if (nvs_get_str(h, "gw",   g_ipcfg_gw,   &l) != ESP_OK) g_ipcfg_gw[0]   = '\0';
    l = sizeof(g_ipcfg_dns);  if (nvs_get_str(h, "dns",  g_ipcfg_dns,  &l) != ESP_OK) g_ipcfg_dns[0]  = '\0';
    nvs_close(h);
}

static void nvs_save_ipcfg(void)
{
    nvs_handle_t h;
    if (nvs_open(NVS_NAMESPACE, NVS_READWRITE, &h) == ESP_OK) {
        nvs_set_u8(h, "ipmode", g_ipcfg_static ? 1 : 0);
        nvs_set_str(h, "ip",   g_ipcfg_ip);
        nvs_set_str(h, "mask", g_ipcfg_mask);
        nvs_set_str(h, "gw",   g_ipcfg_gw);
        nvs_set_str(h, "dns",  g_ipcfg_dns);
        nvs_commit(h);
        nvs_close(h);
        ESP_LOGI(TAG, "IP config saved (%s)", g_ipcfg_static ? "static" : "DHCP");
    }
}

/* Applies a saved static IP to the STA netif before esp_wifi_start(); a no-op
 * (leaves the netif's default DHCP client running) when in DHCP mode or when
 * the saved ip/mask are missing/invalid. */
static void apply_static_ip(esp_netif_t *sta_netif)
{
    if (!g_ipcfg_static || !g_ipcfg_ip[0] || !g_ipcfg_mask[0]) return;

    esp_netif_ip_info_t ip_info = {0};
    if (esp_netif_str_to_ip4(g_ipcfg_ip,   &ip_info.ip)      != ESP_OK ||
        esp_netif_str_to_ip4(g_ipcfg_mask, &ip_info.netmask) != ESP_OK) {
        ESP_LOGW(TAG, "Saved static IP config invalid — falling back to DHCP");
        return;
    }
    if (g_ipcfg_gw[0]) esp_netif_str_to_ip4(g_ipcfg_gw, &ip_info.gw);

    esp_netif_dhcpc_stop(sta_netif);
    esp_netif_set_ip_info(sta_netif, &ip_info);
    if (g_ipcfg_dns[0]) {
        esp_netif_dns_info_t dns_info = {0};
        dns_info.ip.type = ESP_IPADDR_TYPE_V4;
        if (esp_netif_str_to_ip4(g_ipcfg_dns, &dns_info.ip.u_addr.ip4) == ESP_OK)
            esp_netif_set_dns_info(sta_netif, ESP_NETIF_DNS_MAIN, &dns_info);
    }
    ESP_LOGI(TAG, "Static IP applied: %s / %s gw %s", g_ipcfg_ip, g_ipcfg_mask,
             g_ipcfg_gw[0] ? g_ipcfg_gw : "-");
}

/* ── WiFi Event Handler ─────────────────────────────────────────────────────── */
static void wifi_event_handler(void *arg, esp_event_base_t base,
                               int32_t id, void *data)
{
    if (base == WIFI_EVENT) {
        if (id == WIFI_EVENT_STA_START) {
            /* In portal (APSTA) mode the STA config still holds the failed
             * credentials -- don't churn reconnect attempts while the user is
             * using the portal (same guard as both slaves). */
            if (!g_portal_mode) esp_wifi_connect();
        } else if (id == WIFI_EVENT_STA_DISCONNECTED) {
            g_wifi_disconnect_count++;
            g_wifi_last_disc_ts_us = esp_timer_get_time();
            /* Once we've connected at least once, retry forever — MAX_RETRY only
             * governs the initial boot decision to fall back to the config portal. */
            if (s_wifi_ever_connected || s_retry_count < MAX_RETRY) {
                esp_wifi_connect();
                s_retry_count++;
                ESP_LOGI(TAG, "WiFi retry %d/%d", s_retry_count, MAX_RETRY);
            } else {
                xEventGroupSetBits(s_wifi_eg, WIFI_FAIL_BIT);
            }
        }
    } else if (base == IP_EVENT && id == IP_EVENT_STA_GOT_IP) {
        ip_event_got_ip_t *ev = (ip_event_got_ip_t *)data;
        ESP_LOGI(TAG, "IP: " IPSTR, IP2STR(&ev->ip_info.ip));
        s_retry_count = 0;
        s_wifi_ever_connected = true;
        xEventGroupSetBits(s_wifi_eg, WIFI_CONNECTED_BIT);
    }
}

/* ── SoftAP config portal (served by web_server.c) ─────────────────────────── */
/* web_server.c provides /wifi-setup page; credentials posted to /wifi-save    */
/* After save, this flag triggers NVS write + restart.                          */
volatile bool g_wifi_save_requested = false;
char          g_new_ssid[64] = {0};
char          g_new_pass[64] = {0};

/* Watches for a WiFi-credentials or IP-config save requested from the always-
 * available web UI WiFi tab (as opposed to the first-boot config portal,
 * which has its own blocking wait loop in start_config_portal() below) and
 * persists + reboots to apply. Runs for the life of the device once normal
 * (non-portal) operation begins. */
static void config_apply_task(void *arg)
{
    for (;;) {
        if (g_wifi_save_requested) {
            nvs_save_wifi(g_new_ssid, g_new_pass);
            vTaskDelay(pdMS_TO_TICKS(500));
            esp_restart();
        }
        if (g_ipcfg_save_requested) {
            nvs_save_ipcfg();
            vTaskDelay(pdMS_TO_TICKS(500));
            esp_restart();
        }
        vTaskDelay(pdMS_TO_TICKS(200));
    }
}

static void start_config_portal(void)
{
    ESP_LOGI(TAG, "Starting config portal AP: %s", WIFI_AP_SSID);

    esp_netif_create_default_wifi_ap();
    wifi_config_t ap_cfg = {
        .ap = {
            .ssid           = WIFI_AP_SSID,
            .password       = WIFI_AP_PASSWORD,
            .ssid_len       = strlen(WIFI_AP_SSID),
            .channel        = 1,
            .authmode       = WIFI_AUTH_WPA2_PSK,
            .max_connection = 4,
        }
    };
    ESP_ERROR_CHECK(esp_wifi_set_mode(WIFI_MODE_APSTA));
    ESP_ERROR_CHECK(esp_wifi_set_config(WIFI_IF_AP, &ap_cfg));
    ESP_ERROR_CHECK(esp_wifi_start());

    web_server_start();   /* serves /wifi-setup and /wifi-save */

    /* Wait until user submits credentials */
    while (!g_wifi_save_requested) {
        vTaskDelay(pdMS_TO_TICKS(200));
    }
    nvs_save_wifi(g_new_ssid, g_new_pass);
    ESP_LOGI(TAG, "Credentials saved, restarting…");
    vTaskDelay(pdMS_TO_TICKS(500));
    esp_restart();
}

/* ── WiFi Init ──────────────────────────────────────────────────────────────── */
/* http://masterremote.local/ (v1.61): the unit answers on a fixed name, so
 * nobody has to find its DHCP address after setup -- the portal's Saved!
 * page redirects there by itself. Best-effort: a failure never blocks
 * bring-up. mDNS is same-subnet only; other subnets still need the IP. */
static void start_mdns(void)
{
    esp_err_t err = mdns_init();
    if (err != ESP_OK) { ESP_LOGW(TAG, "mdns_init: %s", esp_err_to_name(err)); return; }
    mdns_hostname_set(MDNS_HOSTNAME);
    mdns_instance_name_set(FIRMWARE_NAME);
    mdns_service_add(NULL, "_http", "_tcp", 80, NULL, 0);
    ESP_LOGI(TAG, "mDNS: http://%s.local/", MDNS_HOSTNAME);
}

static void wifi_init_and_connect(void)
{
    s_wifi_eg = xEventGroupCreate();

    ESP_ERROR_CHECK(esp_netif_init());
    ESP_ERROR_CHECK(esp_event_loop_create_default());
    esp_netif_t *sta_netif = esp_netif_create_default_wifi_sta();
    /* Router client lists show this name -- must be set before DHCP starts. */
    esp_netif_set_hostname(sta_netif, MDNS_HOSTNAME);

    wifi_init_config_t cfg = WIFI_INIT_CONFIG_DEFAULT();
    ESP_ERROR_CHECK(esp_wifi_init(&cfg));
    ESP_ERROR_CHECK(esp_wifi_set_mode(WIFI_MODE_STA));   /* own factory MAC, never overridden */

    esp_event_handler_register(WIFI_EVENT, ESP_EVENT_ANY_ID,  &wifi_event_handler, NULL);
    esp_event_handler_register(IP_EVENT,   IP_EVENT_STA_GOT_IP, &wifi_event_handler, NULL);

    nvs_load_ipcfg();

    char ssid[64] = {0}, pass[64] = {0};
    if (nvs_load_wifi(ssid, pass, sizeof(ssid)) == ESP_OK && ssid[0] != '\0') {
        wifi_config_t sta_cfg = {0};
        strlcpy((char *)sta_cfg.sta.ssid,     ssid, sizeof(sta_cfg.sta.ssid));
        strlcpy((char *)sta_cfg.sta.password, pass, sizeof(sta_cfg.sta.password));
        ESP_ERROR_CHECK(esp_wifi_set_config(WIFI_IF_STA, &sta_cfg));
        apply_static_ip(sta_netif);
        start_mdns();
        ESP_ERROR_CHECK(esp_wifi_start());
        /* Default modem-sleep power save (WIFI_PS_MIN_MODEM) makes the radio sleep
         * between beacons and only wake at DTIM intervals to receive buffered
         * packets -- adds real latency to every HTTP request/response, compounding
         * with a marginal RSSI into the flaky web-server symptom seen 2026-07-02.
         * These units are mains/battery-bank powered, not power-constrained, so
         * there's no downside to disabling it. */
        ESP_ERROR_CHECK(esp_wifi_set_ps(WIFI_PS_NONE));
        /* Max TX power (84 = 21 dBm, the top of the 0.25 dBm-unit range) -- not
         * ESP_ERROR_CHECK'd since the actual ceiling is module/chip-dependent and
         * a rejected value here shouldn't be fatal, just leaves the IDF default. */
        esp_err_t txp_err = esp_wifi_set_max_tx_power(84);
        if (txp_err != ESP_OK) ESP_LOGW(TAG, "set_max_tx_power failed: %s", esp_err_to_name(txp_err));

        EventBits_t bits = xEventGroupWaitBits(s_wifi_eg,
            WIFI_CONNECTED_BIT | WIFI_FAIL_BIT, pdFALSE, pdFALSE,
            pdMS_TO_TICKS(15000));

        if (bits & WIFI_CONNECTED_BIT) {
            ESP_LOGI(TAG, "WiFi connected");
            web_server_start();
            return;
        }
        ESP_LOGW(TAG, "WiFi connect failed, opening portal");
        esp_wifi_stop();
    }

    /* No credentials or connect failed → open config portal (WiFi is mandatory for Master) */
    g_portal_mode = true;
    start_config_portal();
    /* Never returns — portal restarts device after save */
}

/* ── ESP-NOW ────────────────────────────────────────────────────────────────── */
static void espnow_send_cb(const esp_now_send_info_t *tx_info, esp_now_send_status_t st)
{
    /* Silently discard; log if needed for debug */
}

static void espnow_add_peer(const uint8_t *mac)
{
    esp_now_peer_info_t peer = {0};
    memcpy(peer.peer_addr, mac, 6);
    peer.channel = 0;   /* 0 = use current WiFi channel */
    peer.encrypt = false;
    if (esp_now_add_peer(&peer) != ESP_OK)
        ESP_LOGE(TAG, "Failed to add peer " MACSTR, MAC2STR(mac));
}

static bool node_connected(const slave_info_t *info)
{
    return info->peer_added &&
           (esp_timer_get_time() - info->last_seen_us) < (int64_t)NODE_TIMEOUT_MS * 1000;
}

/* Register (or re-register, if the MAC changed — e.g. hardware swap) a slave's
 * real MAC as an ESP-NOW peer. Refuses to hand the role to a new MAC while the
 * current holder is still active (within NODE_TIMEOUT_MS) -- closes the door
 * on a rogue sender hijacking a role by simply sending the right label/size.
 * Returns false if the claim was rejected. See FSD §3.2 / §12. */
static bool register_peer(slave_info_t *info, const uint8_t *mac)
{
    if (info->peer_added && memcmp(info->mac, mac, 6) == 0) return true;
    if (info->peer_added && node_connected(info)) {
        ESP_LOGW(TAG, "Ignoring role claim from " MACSTR " -- still held by " MACSTR,
                 MAC2STR(mac), MAC2STR(info->mac));
        return false;
    }
    if (info->peer_added) esp_now_del_peer(info->mac);
    espnow_add_peer(mac);
    memcpy(info->mac, mac, 6);
    info->peer_added = true;
    ESP_LOGI(TAG, "Registered peer " MACSTR, MAC2STR(mac));
    return true;
}

static void espnow_recv_cb(const esp_now_recv_info_t *info,
                           const uint8_t *data, int len)
{
    const uint8_t *src = info->src_addr;

    if (len == (int)sizeof(slave_honda_msg_t)) {
        slave_honda_msg_t msg;
        memcpy(&msg, data, sizeof(msg));
        if (strncmp(msg.label, "SlaveHonda", 10) == 0) {
            if (!register_peer(&g_slave_honda, src)) return;
            g_slave_honda.last_seen_us   = esp_timer_get_time();
            g_slave_honda.honda_ign_on   = msg.HondaIgnitionOn;
            g_slave_honda.honda_starting = msg.HondaStarting;
            g_slave_honda.honda_running  = msg.HondaRunning;
            g_slave_honda.has_wifi       = msg.has_wifi;
            g_slave_honda.rssi           = msg.rssi;
            g_slave_honda.channel        = msg.channel;
            strlcpy(g_slave_honda.ip, msg.ip, sizeof(g_slave_honda.ip));
            strlcpy(g_slave_honda.fw_version, msg.fw_version, sizeof(g_slave_honda.fw_version));
            g_slave_honda_running = msg.HondaRunning;
            gpio_set_level(PIN_HONDA_STARTED_FB, msg.HondaRunning ? 1 : 0);
            return;
        }
    }
    if (len == (int)sizeof(slave_wallas_msg_t)) {
        slave_wallas_msg_t msg;
        memcpy(&msg, data, sizeof(msg));
        if (strncmp(msg.label, "SlaveWallas", 11) == 0) {
            bool was_connected = node_connected(&g_slave_wallas);
            if (!register_peer(&g_slave_wallas, src)) return;
            if (!was_connected) {
                /* Newly (re)joined -- possibly after running standalone: give it
                 * the command and compare timers now, not at the next tick. */
                g_wallas_force_send = true;
                s_timer_sync_due_us = 0;
            }
            g_slave_wallas.last_seen_us  = esp_timer_get_time();
            g_slave_wallas.wallas_running = msg.WallasRunning;
            g_slave_wallas.has_wifi       = msg.has_wifi;
            g_slave_wallas.rssi           = msg.rssi;
            g_slave_wallas.channel        = msg.channel;
            strlcpy(g_slave_wallas.ip, msg.ip, sizeof(g_slave_wallas.ip));
            strlcpy(g_slave_wallas.fw_version, msg.fw_version, sizeof(g_slave_wallas.fw_version));
        }
        return;
    }

    /* The two SlaveWallas -> Master messages below are only trusted from the
     * MAC that holds the SlaveWallas role (the relay's MAC when relayed). */
    bool from_wallas = g_slave_wallas.peer_added && memcmp(src, g_slave_wallas.mac, 6) == 0;

    if (len == (int)sizeof(wallas_timer_msg_t) && from_wallas) {
        if (strncmp((const char *)data, "SlaveWallas->Timer", 18) != 0) return;
        if (s_timer_in_pending) return;   /* previous one not applied yet; the next periodic send covers it */
        memcpy(&s_timer_in, data, sizeof(s_timer_in));
        s_timer_in_pending = true;
        return;
    }

    if (len == (int)sizeof(wallas_webcmd_msg_t) && from_wallas) {
        wallas_webcmd_msg_t m;
        memcpy(&m, data, sizeof(m));
        if (strncmp(m.label, "SlaveWallas->WebCmd", 19) != 0) return;
        /* Exactly what this unit's own Start/Stop Wallas buttons do. */
        g_web_wallas_start  = m.start != 0;
        g_wallas_start_cmd  = wallas_cmd_compute();
        g_wallas_force_send = true;
        ESP_LOGI(TAG, "Wallas %s pressed on SlaveWallas", m.start ? "Start" : "Stop");
    }
}

static void send_timer_to_wallas(void)
{
    wallas_timer_msg_t m;
    timer_fill_msg(&m);
    esp_now_send(g_slave_wallas.mac, (uint8_t *)&m, sizeof(m));
}

static void espnow_init(void)
{
    ESP_ERROR_CHECK(esp_now_init());
    esp_now_register_send_cb(espnow_send_cb);
    esp_now_register_recv_cb(espnow_recv_cb);
    espnow_add_peer(BROADCAST_MAC);   /* needed to send the discovery beacon */
    ESP_LOGI(TAG, "ESP-NOW ready");
}

static void send_beacon(void)
{
    master_beacon_t beacon = {0};
    strlcpy(beacon.label, "MasterRemote", sizeof(beacon.label));
    esp_now_send(BROADCAST_MAC, (uint8_t *)&beacon, sizeof(beacon));
}

static void send_to_honda(void)
{
    if (!node_connected(&g_slave_honda)) return;   /* nothing to send to yet */
    master_msg_t msg = {0};
    strlcpy(msg.label, "Master->SlaveHonda", sizeof(msg.label));
    msg.HondaRunningFB  = g_slave_honda_running;
    msg.HondaIgnitionOn = (g_input_enable & IN_EN_HONDA_MANUAL) && gpio_get_level(PIN_HONDA_MANUAL_START);
    msg.HondaStart      = g_honda_start_cmd;
    esp_now_send(g_slave_honda.mac, (uint8_t *)&msg, sizeof(msg));
    vTaskDelay(pdMS_TO_TICKS(20));
    esp_now_send(g_slave_honda.mac, (uint8_t *)&msg, sizeof(msg)); /* redundant */
    ESP_LOGI(TAG, "Honda CMD: start=%d", msg.HondaStart);
}

static void send_to_wallas(void)
{
    if (!node_connected(&g_slave_wallas)) return;   /* nothing to send to yet */
    master_msg_t msg = {0};
    strlcpy(msg.label, "Master->SlaveWallas", sizeof(msg.label));
    msg.HondaStart = g_wallas_start_cmd;
    g_slave_wallas.wallas_start_cmd = g_wallas_start_cmd;
    esp_now_send(g_slave_wallas.mac, (uint8_t *)&msg, sizeof(msg));
    ESP_LOGI(TAG, "Wallas CMD: start=%d", msg.HondaStart);
}

/* ── GPIO ISR ───────────────────────────────────────────────────────────────── */
/* One recompute per command, attached to every pin that feeds it. Each ISR
 * must OR in ALL of its command's sources -- an edge on one pin recomputing
 * from a subset silently drops the other sources' contribution (e.g. a manual
 * button release would cancel a still-active Victron relay demand). Same OR
 * expressions as h_honda_stop/h_wallas_stop/timer_task recomputes. */
static void IRAM_ATTR isr_honda_recompute(void *arg)
{
    g_honda_start_cmd = honda_cmd_compute();
}
/* PIN_WALLAS_START (GPIO4) reads inverted on this hardware revision (LOW =
 * Victron demanding start) -- opposite of PIN_HONDA_START's polarity, and
 * opposite of what earlier hardware used. PIN_WALLAS_MANUAL_START (GPIO5),
 * reconnected 2026-07-04 (previously permanently unwired/obsolete, see FSD
 * §2.1/§12), is a maintained on/off switch, not a momentary button -- like
 * PIN_HONDA_MANUAL_START it reads NON-inverted (confirmed live: raw LOW in
 * the switch's Off position, HIGH in On -- the switch grounds the pin when
 * Off and leaves it floating/pulled-up when On, same convention as Honda's
 * manual switch). It OR's in as a plain level source alongside the Victron
 * relay: On continuously demands start, Off just stops contributing
 * (other sources can still keep Wallas running). */
static void IRAM_ATTR isr_wallas_recompute(void *arg)
{
    g_wallas_start_cmd = wallas_cmd_compute();
}

static void gpio_init(void)
{
    /* Outputs */
    gpio_config_t out = {
        .pin_bit_mask = (1ULL << PIN_HONDA_STARTED_FB) | (1ULL << PIN_STATUS_LED),
        /* INPUT_OUTPUT (not plain OUTPUT): enables the read-back buffer so
         * gpio_get_level() returns the actual driven level -- a plain OUTPUT
         * pin always reads 0, which made /api/status's pFB field permanently
         * false regardless of the LED's true state (FSD v1.36). */
        .mode         = GPIO_MODE_INPUT_OUTPUT,
        .intr_type    = GPIO_INTR_DISABLE,
    };
    gpio_config(&out);
    gpio_set_level(PIN_HONDA_STARTED_FB, 0);
    gpio_set_level(PIN_STATUS_LED, 0);

    /* All four inputs with internal pull-up. The Victron inputs (GPIO15/GPIO4)
     * also have the interface board's external 10 k pull-up and are pulled LOW
     * by the opto when active; the internal one is what makes an unconnected
     * pin (board absent, broken wire) read HIGH = idle instead of floating LOW
     * = start demand (v1.55). The manual switches ground their pin when Off. */
    gpio_config_t in_pu = {
        .pin_bit_mask = (1ULL << PIN_HONDA_START) | (1ULL << PIN_WALLAS_START) |
                        (1ULL << PIN_HONDA_MANUAL_START) | (1ULL << PIN_WALLAS_MANUAL_START),
        .mode         = GPIO_MODE_INPUT,
        .pull_up_en   = GPIO_PULLUP_ENABLE,
        .pull_down_en = GPIO_PULLDOWN_DISABLE,
        .intr_type    = GPIO_INTR_ANYEDGE,
    };
    gpio_config(&in_pu);

    /* Read initial states -- same compute as every other site (web/timer
     * sources are always false here) */
    input_enable_load();
    g_honda_start_cmd  = honda_cmd_compute();
    g_wallas_start_cmd = wallas_cmd_compute();

    gpio_install_isr_service(ESP_INTR_FLAG_IRAM);
    gpio_isr_handler_add(PIN_HONDA_START,         isr_honda_recompute,  NULL);
    gpio_isr_handler_add(PIN_HONDA_MANUAL_START,  isr_honda_recompute,  NULL);
    gpio_isr_handler_add(PIN_WALLAS_START,        isr_wallas_recompute, NULL);
    gpio_isr_handler_add(PIN_WALLAS_MANUAL_START, isr_wallas_recompute, NULL);
}

/* ── Beacon Task ────────────────────────────────────────────────────────────── */
static void beacon_task(void *arg)
{
    for (;;) {
        send_beacon();
        vTaskDelay(pdMS_TO_TICKS(BEACON_INTERVAL_MS));
    }
}

/* ── Main Control Task ──────────────────────────────────────────────────────── */
static void master_task(void *arg)
{
    int64_t last_honda_send_us  = 0;
    int64_t last_wallas_send_us = 0;

    for (;;) {
        int64_t now = esp_timer_get_time();

        /* Honda: send when desired ≠ actual and restart block has elapsed,
         * or unconditionally once if a manual web button just forced it. */
        if ((g_honda_force_send ||
             ((g_honda_start_cmd != g_slave_honda_running) &&
              (now - last_honda_send_us) >= (int64_t)HONDA_RESTART_BLOCK_MS * 1000))) {
            last_honda_send_us = now;
            g_honda_force_send = false;
            send_to_honda();
        }

        /* Wallas: periodic refresh, or now if forced */
        if (g_wallas_force_send ||
            (now - last_wallas_send_us) >= (int64_t)WALLAS_SEND_INTERVAL_MS * 1000) {
            last_wallas_send_us = now;
            g_wallas_force_send = false;
            send_to_wallas();
        }

        /* Weekly timer sync with SlaveWallas: adopt a newer table it sent,
         * send ours back if it was older, and send ours every minute. */
        if (s_timer_in_pending) {
            if (timer_apply_msg(&s_timer_in)) {
                ESP_LOGI(TAG, "Weekly timer taken from SlaveWallas (rev %lu)", (unsigned long)s_timer_rev);
            } else if (s_timer_in.rev < s_timer_rev) {
                s_timer_sync_due_us = 0;
            }
            s_timer_in_pending = false;
        }
        if (node_connected(&g_slave_wallas) && now >= s_timer_sync_due_us) {
            s_timer_sync_due_us = now + TIMER_SYNC_INTERVAL_US;
            send_timer_to_wallas();
        }

        /* Heartbeat LED: 1 Hz */
        gpio_set_level(PIN_STATUS_LED,
                       (esp_timer_get_time() / 500000) % 2 == 0 ? 1 : 0);

        vTaskDelay(pdMS_TO_TICKS(50));
    }
}

/* ── app_main ───────────────────────────────────────────────────────────────── */
void app_main(void)
{
    ESP_LOGI(TAG, "=== %s v%s ===", FIRMWARE_NAME, FIRMWARE_VERSION);

    /* NVS */
    esp_err_t ret = nvs_flash_init();
    if (ret == ESP_ERR_NVS_NO_FREE_PAGES || ret == ESP_ERR_NVS_NEW_VERSION_FOUND) {
        nvs_flash_erase();
        nvs_flash_init();
    }

    /* GPIO */
    gpio_init();

    /* WiFi → if no credentials: opens portal (blocks until saved + restart) */
    wifi_init_and_connect();

    /* ESP-NOW (must be after WiFi connected for correct channel) */
    espnow_init();

    /* NTP + weekly Wallas timer (WiFi is mandatory for this unit, so it's
     * already connected by this point) */
    ntp_init();
    timer_nvs_load();

    /* Beacon + main control logic tasks */
    xTaskCreate(beacon_task,       "beacon",  2048, NULL, 4, NULL);
    xTaskCreate(master_task,       "master",  4096, NULL, 5, NULL);
    xTaskCreate(timer_task,        "timer",   3072, NULL, 3, NULL);
    xTaskCreate(config_apply_task, "cfgapply",2048, NULL, 3, NULL);

    ESP_LOGI(TAG, "Ready");
}
