SEspe/RemoteStart/ESPNowRelay/main/version.h

#pragma once

#define FIRMWARE_VERSION    "1.3.0"
#define FIRMWARE_NAME       "ESPNowRelay"
#define MDNS_HOSTNAME       "espnowrelay"   /* http://espnowrelay.local/ and the DHCP hostname */
#define WIFI_AP_SSID        "ESPNowRelay-Config"
#define WIFI_AP_PASSWORD    "honda1234"
#define NVS_NAMESPACE       "esprelay"
