SEspe/RemoteStart/SlaveHonda/main/version.h

#pragma once

#define FIRMWARE_VERSION    "1.5.0"
#define FIRMWARE_NAME       "SlaveHonda"
#define MDNS_HOSTNAME       "slavehonda"   /* http://slavehonda.local/ and the DHCP hostname */
#define WIFI_AP_SSID        "SlaveHonda-Config"
#define WIFI_AP_PASSWORD    "honda1234"
#define NVS_NAMESPACE       "shonda"
