SEspe/RemoteStart/SlaveWallas/main/version.h

#pragma once

#define FIRMWARE_VERSION    "1.8.0"
#define FIRMWARE_NAME       "SlaveWallas"
#define MDNS_HOSTNAME       "slavewallas"   /* http://slavewallas.local/ and the DHCP hostname */
#define WIFI_AP_SSID        "SlaveWallas-Config"
#define WIFI_AP_PASSWORD    "honda1234"
#define NVS_NAMESPACE       "swallas"
