SEspe/RemoteStart/(commit log)

2026-06-30 Initial release v1.0.0 — ESP32 conversion with WiFiManager, web UI, OTA
    All three units converted to ESP32 with:
    - WiFiManager captive portal for first-startup WiFi config
    - ESPAsyncWebServer + ElegantOTA for browser-based OTA updates
    - Tabbed web UI: Status, (Clients on Master), OTA Update
    - Individual firmware versions (MasterHonda/SlaveHonda/SlaveWallas v1.0.0)
    - ESP-NOW channel auto-matched to connected WiFi AP
    - SlaveWallas converted from ESP8266 to ESP32
    - FSD_RemoteStart.md: full functional specification document
    Claude-Session: https://claude.ai/code/session_01JF7nYQa44jLcDc8KyCrkuN
2026-06-30 Add GitHub Actions build & release workflow
    Workflow triggers on version tags and compiles all three ESP32 sketches
    using arduino/compile-sketches, then creates a GitHub release with the
    individual .bin files as assets:
    MasterHonda_v<ver>.bin
    SlaveHonda_v<ver>.bin
    SlaveWallas_v<ver>.bin
    Tag patterns:
    v* → builds all three
    master-v* → builds MasterHonda only
    honda-v* → builds SlaveHonda only
    wallas-v* → builds SlaveWallas only
    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
2026-06-30 Convert to ESP-IDF v5 — native C firmware, no Arduino framework
    Each unit is now a standalone ESP-IDF CMake project:
    MasterHonda/ — CMakeLists.txt + partitions.csv + sdkconfig.defaults
    main/{main.c, web_server.c, web_server.h, version.h}
    SlaveHonda/ — same structure
    SlaveWallas/ — same structure (converted from ESP8266)
    Replaced Arduino libraries with native ESP-IDF equivalents:
    WiFiManager → NVS-backed SoftAP captive portal (esp_wifi + esp_http_server)
    ESPAsyncWebServer → esp_http_server (sync, task-based)
    ElegantOTA → esp_ota_ops streaming POST upload (/ota/upload)
    Preferences → nvs_flash / nvs
    Build a unit: cd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
    [partitions.csv]
2026-06-30 Update FSD to reflect ESP-IDF v5 conversion
    Removes all Arduino/library references (WiFiManager, ESPAsyncWebServer,
    ElegantOTA) and replaces them with the actual ESP-IDF implementation:
    NVS-backed SoftAP portal, esp_http_server, esp_ota_ops streaming OTA,
    idf.py build workflow, CMakeLists project structure, and component table.
    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
2026-06-30 Fix ESP-IDF v6 compatibility for all three units
    - esp_now moved to esp_wifi component (remove managed component dep)
    - driver/gpio.h moved to esp_driver_gpio component
    - esp_now_register_send_cb callback signature: (uint8_t*,status) -> (send_info_t*,status)
    - esp_ota_ops not a standalone component, covered by app_update
    - MIN macro requires sys/param.h in ESP-IDF v6
    - Add CONFIG_ESPTOOLPY_FLASHSIZE_4MB=y to sdkconfig.defaults (dual OTA partitions need 4MB)
    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
    [SlaveWallas8266.ino, main.c, web_server.c]
2026-06-30 Set SlaveWallas target to esp32c6 in CI and sdkconfig.defaults
    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
2026-07-01 Update FSD to v1.2 and bump CI to ESP-IDF v6.0.1
    Documents the ESP-IDF v6 migration (esp_now.h under esp_wifi, esp_driver_gpio,
    v6 send-callback signature), SlaveWallas ESP32-C6 target, and the in-progress
    WiFi scan-and-connect portal feature. Also fixes release.yml to build with
    v6.0.1 instead of v5.2.1, and corrects the release notes' esptool chip flag
    for SlaveWallas (esp32c6 vs esp32).
    Claude-Session: https://claude.ai/code/session_01HYNBCUjgehsJgq4AcH9WbP
2026-07-01 Enable USB-Serial/JTAG console for SlaveWallas (ESP32-C6)
    ESP32-C6 has no separate UART bridge chip; console/logging needs the native
    USB-Serial/JTAG peripheral instead of the default UART console.
    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
2026-07-01 Replace custom MAC addressing with dynamic peer discovery (FSD v1.3)
    Units now use their own factory MAC and find each other by function role
    instead of a hardcoded peer table: MasterHonda broadcasts a discovery
    beacon while WiFi-connected, and slaves that hear it learn Master's MAC
    and register themselves via their existing heartbeat (now carrying ip/
    has_wifi). No pairing step or NVS persistence is needed — the roster is
    rebuilt every boot, so any unit's hardware can be swapped freely.
    SlaveWallas keeps its WiFi-mandatory behavior. SlaveHonda now tries WiFi
    first but, if it can't connect with existing credentials, skips the
    config portal and instead scans ESP-NOW channels 1-13 for Maste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
    [main.c, web_server.c]
2026-07-01 Fix SlaveWallas relay GPIO: 0 -> 16
    The heater relay is wired to GPIO16 on the physical hardware, not GPIO0
    as previously defined. Bumps SlaveWallas to v1.0.1 (bugfix).
    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
    [main.c, version.h, web_server.c]
2026-07-01 SlaveWallas GPIO23 heater indicator LED; MasterHonda WiFi RSSI/channel status
    SlaveWallas (v1.1.0): adds a GPIO23 indicator LED driven alongside the relay
    in wallas_start()/wallas_stop(), giving a hardware-level confirmation of the
    relay command that doesn't depend on gpio_get_level() readback of an
    output-only pin (which isn't reliable — documented as a known limitation).
    MasterHonda (v1.1.0): /api/status and the Pin Status tab now report WiFi
    signal strength (RSSI) and channel via esp_wifi_sta_get_ap_info().
    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
    [main.c, version.h, web_server.c]
2026-07-01 Fix OTA upload hang on client abort; move SlaveWallas GPIO13 off USB-JTAG pin
    h_ota_upload() retried httpd_req_recv() forever on HTTPD_SOCK_ERR_TIMEOUT,
    so a client aborting mid-upload (e.g. a dropped connection) could wedge the
    httpd worker permanently -- and since there's only one, the whole web server
    -- until a USB reflash. Reproduced on MasterHonda during testing and
    recovered via USB. Now bounded to 5 consecutive timeouts before aborting.
    Applied to all three units.
    SlaveWallas: PIN_WALLAS_FB moved from GPIO13 to GPIO18. GPIO12/13 are
    hard-wired to the ESP32-C6's native USB-Serial/JTAG peripheral (D-/D+);
    using GPIO13 as a plain input pin conflicts with that and likely explains
    earlie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
    [main.c, version.h, web_server.c]
2026-07-01 Per-node RSSI/channel/firmware version, Nodes table redesign, manual control
    Slave heartbeats now carry RSSI, channel, and firmware version, sourced
    from esp_now_recv_info_t.rx_ctrl on the last frame heard from MasterHonda
    -- works identically whether or not the slave has its own WiFi/AP
    association, so SlaveHonda reports real link quality even in ESP-NOW-only
    fallback mode.
    MasterHonda's Nodes tab is now a genuine HTML table (one row per node)
    instead of stacked cards, with columns for role, firmware, MAC, IP, WiFi,
    RSSI, channel, connected status, last seen, running status, and a
    role-specific detail column.
    Added manual Start/Stop Honda and Start/Stop Wallas buttons to the Pin
    Status ta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
    [main.c, version.h, web_server.c]
2026-07-01 Fix heap buffer overflow in h_root() %IP% substitution on all three units
    The %IP% placeholder (4 chars) was replaced in-place via memmove/memcpy
    inside a strdup()'d buffer sized only for the original template. Any IP
    string longer than 4 characters -- i.e. almost any real IP -- overflowed
    that allocation, corrupting the heap and crashing the device shortly
    after, usually visible as the TCP connection to / resetting mid-response
    while smaller endpoints like /api/status kept working fine.
    Reproduced on SlaveWallas: loading / reliably crashed it. SlaveHonda's
    root page happened to work only because it currently has no WiFi IP, so
    the placeholder became "?" (1 char, shrinks rather than overflo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
    [version.h, web_server.c]
2026-07-01 SlaveWallas: fix stale pin labels, add Debug GPIO tab for hardware bring-up
    Status tab labels still said "p0" (relay) and "p13" (feedback) after
    those were moved to GPIO16 and GPIO18 in earlier fixes -- display only,
    the actual pin defines were already correct.
    Added a Debug GPIO tab: GET /api/gpio/set?pin=N&level=0|1 reconfigures
    any non-reserved GPIO to OUTPUT and drives it, so wiring can be verified
    physically when pin assignments are uncertain. Reserved pins (strapping
    4/5/8/9/15, USB-JTAG 12/13) are excluded from the UI. Hardware bring-up
    tool only -- overrides normal operation of whatever pin is toggled until
    the next reboot.
    Cl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
    [version.h, web_server.c]
2026-07-01 SlaveWallas: correct heater relay pin, GPIO16 -> GPIO19
    Confirmed via the Debug GPIO tab that the relay is actually wired to
    GPIO19, not GPIO16. GPIO2 confirmed as the onboard status LED, already
    correct (blinks by design).
    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
    [main.c, version.h, web_server.c]
2026-07-01 SlaveWallas: key status LED blink off start command, not feedback sensor
    The running-feedback sensor (PIN_WALLAS_FB, GPIO18) isn't wired up on this
    unit yet, so the LED's fast/slow blink previously couldn't reflect
    anything meaningful. Now keyed off g_start_cmd (start commanded by
    Master) instead of g_wallas_running.
    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
2026-07-01 SlaveWallas: show live status dot for every GPIO on the Debug tab
    All GPIO 0-30 now get a green/off status dot (read-only, via new
    GET /api/gpio/status), not just the manipulable subset -- lets you see
    what a pin is doing before deciding whether to force it. gpio_get_level()
    alone is passive so this is safe to call on reserved pins too, unlike
    h_gpio_set which actively reconfigures the pin. ON/OFF buttons remain
    restricted to the non-reserved subset.
    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
2026-07-01 Update README to reflect ESP-IDF v6 native C, not the old Arduino stack
    README still described the pre-conversion implementation (Arduino IDE,
    WiFiManager, ESPAsyncWebServer, ElegantOTA) even though the project moved
    to native ESP-IDF v6 firmware a long time ago -- confirmed the FSD itself
    was already accurate here, only README was stale. Also fixes SlaveWallas's
    MCU (was listed as plain ESP32, actually ESP32-C6) and adds the current
    build/flash commands and feature list (dynamic peer discovery, SlaveHonda
    ESP-NOW fallback, native captive portal).
    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
2026-07-01 Add Debug GPIO tab to SlaveHonda; add heater LED lamp to SlaveWallas Status
    SlaveHonda gains the same Debug GPIO tool SlaveWallas has -- live status
    dot for every GPIO 0-39, ON/OFF buttons on the non-reserved subset
    (4,13,14,16-19,21-23,25-27,32,33), adapted for the ESP32-classic pin map
    (strapping 0/2/5/12/15, embedded flash 6-11, UART0 console 1/3, and
    input-only 34-39 excluded from buttons but still shown).
    SlaveWallas's regular Status tab was missing a lamp for the GPIO23 heater
    indicator LED (only visible via the Debug tab before) -- added as a row
    using the same led()/row() pattern already used for cmd/relay/run.
    Claude-Session: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
    [version.h, web_server.c]
2026-07-01 Rename MasterHonda unit to MasterRemote throughout
    Renamed the project directory (git history preserved), FIRMWARE_NAME,
    config-portal AP SSID (MasterRemote-Config), CMake project name, HTML
    title/header, and every mention across the FSD, README, and CI workflow.
    NVS_NAMESPACE deliberately left as "mhonda" so the already-deployed unit
    keeps its stored WiFi credentials.
    Breaking change: the discovery beacon's identity string changed length
    ("MasterHonda" 11 chars -> "MasterRemote" 12 chars) and both slaves'
    strncmp() match against it -- all three units updated together
    (MasterRemote 1.3.0, SlaveHonda 1.2.1, SlaveWallas 1.4.2) since a
    mismatched pair would fail to discover each other.
    Co-Aut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
    [partitions.csv]
2026-07-01 Rename MasterHonda unit to MasterRemote throughout (content)
    Renamed FIRMWARE_NAME, config-portal AP SSID (MasterRemote-Config),
    CMake project name, HTML title/header, and every mention across the
    FSD, README, and CI workflow. NVS_NAMESPACE deliberately left as
    "mhonda" so the already-deployed unit keeps its stored WiFi credentials.
    The directory rename itself (git mv) was co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
    [main.c, version.h, web_server.c]
2026-07-01 Fix Honda manual start/stop button silently not sending
    master_task's Honda send is edge-triggered on g_honda_start_cmd !=
    g_slave_honda_running (Master's last-known feedback from the slave),
    unlike Wallas which just resends every 15s unconditionally. If that
    last-known state already equalled the button's target (e.g. an
    unconnected/floating running-feedback pin reading as permanently
    "running"), the mismatch check was never true and the command never
    went out -- exactly what was observed: Wallas's button worked (via
    periodic resend), Honda's didn't.
    Added g_honda_force_send, set by both /api/honda/start and
    /api/honda/stop, forcing one send on the next master_task tick
    regardless of the mi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
    [main.c, version.h, web_server.c]
2026-07-01 SlaveHonda: match onboard LED (GPIO2) blink pattern to SlaveWallas
    Fast (200ms half-period) when start commanded by Master, slow (1s) when
    idle -- previously a fixed 1Hz blink regardless of state.
    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
    [main.c, version.h]
2026-07-01 Harden command authenticity: source-MAC verification, sticky trust
    Slaves previously accepted a master_msg_t start/stop command from any
    ESP-NOW sender of the right message size -- the source MAC was never
    checked. Now they only act on commands from the exact MAC registered as
    Master via the beacon, and refuse to re-home trust to a new beacon
    claimant while the current Master is still active (30s staleness
    window) -- closing the "spoof a beacon first, then send commands from
    that MAC" loophole.
    Symmetrically, MasterRemote's register_peer() now refuses to hand a
    slave role (SlaveHonda/SlaveWallas) to a new MAC while the current
    holder is still within the node-stale timeout, preventing a rogu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
    [main.c, version.h]
2026-07-01 Add NTP clock and weekly Wallas timer to MasterRemote
    Syncs time via SNTP (pool.ntp.org) in CET/CEST (Europe/Oslo, auto-DST)
    once WiFi connects. New Weekly Timer tab configures an independent
    enable/start/stop window per day of the week, persisted in NVS.
    The timer is a fourth Wallas command source, OR'd in alongside the
    Victron relay, physical manual button, and web override -- active
    whenever today is enabled and local time falls in [start, stop). A
    window crossing midnight (e.g. 22:00-02:00) is handled correctly. Never
    activates before the clock's first successful sync, guarded by a sanity
    floor (2024-01-01) so an unsynced ~1970 clock can't produce a false
    match.
    Exposed to web_server.c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
    [main.c, version.h, web_server.c]
2026-07-01 Fix weekly Wallas timer never actually activating
    timer_task set g_timer_wallas_start every tick, but nothing recomputed
    g_wallas_start_cmd from it outside of a GPIO edge or a web button click
    -- a plain clock tick reaching a schedule boundary was neither. Same
    class of bug as the earlier Honda force-send fix: setting an OR-source
    flag isn't enough if nothing re-evaluates the combined command.
    Caught immediately during live testing -- v1.5.0 silently never turned
    the heater on for an active window.
    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
    [main.c, version.h]
2026-07-01 Weekly Timer tab: batch edits behind a single Set button instead of per-field autosave
    Editing a day's enabled/start/stop previously fired a save on every
    onchange, with no confirmation and no way to review a set of edits
    before committing them. Now all 7 rows stage locally and a single
    Set button (disabled until something changes) commits every row in
    one click.
    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
2026-07-01 README: document Weekly Timer tab and NTP clock feature on MasterRemote
    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
2026-07-01 SlaveWallas Debug GPIO tab: make the live-level dot readable
    The bold, centered "GPIOnn" label was crowding the 12px status dot
    sitting inline right before it, making it easy to miss. Reformat as
    "GPIOnn : <dot>" so the indicator reads clearly on its own; ON/OFF
    buttons stay on their own line below, unchanged.
    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
2026-07-01 Fix invisible Debug GPIO status dot on SlaveWallas and SlaveHonda
    The dot is a <span class="led">, but .led's CSS only set width/height/
    border-radius -- properties an inline element silently ignores. Add
    display:inline-block so it actually renders. Pre-existing bug in both
    units' identical Debug GPIO tab, just went unnoticed until the v1.23
    reorder made its absence obvious instead of it being buried in front
    of bold text.
    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
    [version.h, web_server.c]
2026-07-02 Fix permanent WiFi reconnect giveaway that killed all web servers; add resource monitor
    wifi_event_handler's STA_DISCONNECTED case capped reconnect attempts at
    MAX_RETRY (5) and then gave up forever, since the WIFI_FAIL_BIT it set was
    only ever waited on once during boot. Any transient WiFi hiccup deep into
    runtime (router reboot, interference) would permanently strand the STA,
    killing the web server on all three units while ESP-NOW kept working
    (radio-layer, no AP association needed) -- exactly what was observed:
    MasterRemote needed a manual power cycle, slaves showed up with no IP but
    working heartbeats/commands. Now latches "connected at least once since
    boot" and retries indefinitely aft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
2026-07-02 Add heap low-water-mark timestamp; fix Debug GPIO dot vertical centering
    heapMin previously came from esp_get_minimum_free_heap_size(), which is
    exact but has no notion of when that minimum happened -- can't tell "dipped
    once at boot" from "still actively leaking". Replaced with a self-sampled
    low-water mark paired with a timestamp (g_heap_min/g_heap_min_ts_us,
    updated in each unit's existing periodic task), exposed as a new
    heapMinAgo field on /api/sysinfo.
    Also fixed the Debug GPIO tab's "GPIOnn : *" status dot sitting visibly
    below the text's vertical center -- vertical-align:middle on an inline
    span depends on font metrics that don't reliably center a 12px circle
    against arbitrary text.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
2026-07-02 Fix silent OTA-breaking httpd handler-cap overflow on SlaveHonda
    max_uri_handlers was hardcoded to 8, exactly matching the route count
    before v1.25/v1.26 added /api/sysinfo -- the 9th route pushed /ota/upload
    (last in the array) past the cap. httpd_register_uri_handler()'s return
    value was never checked, so this failed silently: server started fine,
    every other route worked, only /ota/upload 404'd with nothing in the log
    to explain why. Found when a routine v1.10.0 OTA deploy hit an immediate
    404 against SlaveHonda.
    SlaveWallas and MasterRemote had the identical fragility -- both sized to
    exactly their current route count (9 and 14) with zero headroom, so
    either would have broken the same w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
2026-07-02 Fix Wallas GPIO polarity/wiring for the replacement MasterRemote unit
    The physical MasterRemote board was replaced. The new board's Wallas wiring
    differs from the old one: GPIO4 (Victron relay input) is active-LOW instead
    of active-HIGH (opposite of GPIO15's Honda relay input, which is unchanged),
    and GPIO5 (manual button) is now permanently unwired -- the physical button
    was removed from this installation.
    Before this fix, g_wallas_start_cmd read GPIO4 non-inverted (backwards) and
    still OR'd in GPIO5's now-floating, unpredictable reading as a live command
    source -- capable of asserting a start with no real input driving it.
    Fixed all four recompute sites to invert GPIO4 and drop GPIO5 fro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
2026-07-02 Exclude unwired SlaveHonda running-feedback pin from command logic
    The new SlaveHonda unit's GPIO15 (running feedback) isn't wired to a
    physical sensor yet. Confirmed live: with the generator and ignition
    genuinely off, the unit still reported running:true -- the pin has no
    pull resistor (by design, meant to be actively driven by a real sensor)
    and floats to a false-positive reading when unconnected.
    Not just a display bug: MasterRemote only resends a Honda start command
    on a mismatch between g_honda_start_cmd and the slave's last-known
    running state, so a false "already running" reading would silently
    suppress a real start command from ever being sent.
    Fixed by hardcoding g_honda_running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
2026-07-02 Fix live safety bug: SlaveHonda re-cranking starter on already-running engine
    v1.30 excluded the unwired running-feedback pin by hardcoding
    g_honda_running = false unconditionally in send_status() (the 10s
    heartbeat), which stomped whatever honda_start() had just set. SlaveHonda
    therefore always reported "not running" to MasterRemote regardless of
    outcome.
    MasterRemote's Honda send gate only stops resending once it sees the
    reported running state match the desired one -- with SlaveHonda
    permanently reporting false, Master resent the start command every
    HONDA_RESTART_BLOCK_MS (30s) forever, and since a Honda start command is
    not idempotent (each one spawns a full crank sequence), this repeat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
2026-07-02 Disable WiFi power save, max TX power on all three units
    Motivated by SlaveWallas's web server staying flaky even after a fresh
    reconnect at good RSSI (-60 dBm). The boot log confirmed modem-sleep
    power save was active (wifi:pm start, type: 1) -- the radio sleeps
    between beacons and only wakes at DTIM intervals to receive buffered
    packets, adding latency to every HTTP exchange independent of raw signal
    strength. Combined with any marginal link, that compounds into the
    timeout/flakiness pattern seen throughout today.
    Added esp_wifi_set_ps(WIFI_PS_NONE) and esp_wifi_set_max_tx_power(84)
    right after esp_wifi_start() on the STA connect path, all three units.
    These are mains/battery-bank powered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
2026-07-02 Add ESPNowRelay: optional ESP-NOW store-and-forward repeater (new 4th unit)
    New ESP32-C6 unit that extends radio reach between MasterRemote and a
    slave out of direct reach, as a transparent proxy -- ZERO firmware
    changes on the existing three units:
    - Re-broadcasts MasterRemote's discovery beacon verbatim; a far slave
    adopts the relay as its "Master" once its direct claim goes stale.
    - Forwards slave heartbeats verbatim to the real Master, which registers
    the relay's MAC as that role's holder.
    - Forwards Master's commands verbatim to the real slave, destination
    picked from the command label.
    Trust and direct<->relayed failover come free from the existing MAC +
    30s staleness rules; wi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
2026-07-02 Enable httpd LRU purge on all four units (session-socket exhaustion fix)
    Root cause of the day-long intermittent "web server dead while ESP-NOW
    keeps working" pattern: ESP-IDF httpd defaults to 7 session sockets with
    lru_purge_enable OFF. Every client connection abandoned without a clean
    close (keep-alives, polls hitting client-side timeouts) permanently
    occupies a slot; once all 7 are dead-but-held, HTTP is never serviced
    again until reboot.
    Definitively diagnosed live on MasterRemote: ICMP ping 6-10ms, raw TCP
    handshake to :80 accepted (kernel backlog), HTTP never serviced. Heavy
    status polling with hard timeouts -- today's traffic pattern exactly --
    leaks sessions fastest, which is why a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
2026-07-02 Fix output-pin status readbacks: GPIO_MODE_INPUT_OUTPUT on status outputs
    User-reported: SlaveHonda physically sequences correctly (ignition then
    crank), but the web UI's ignition/starter dots showed true constantly.
    Root cause: a plain GPIO_MODE_OUTPUT pin has its input buffer disabled
    on ESP32, so gpio_get_level() always returns 0. Through SlaveHonda's
    active-LOW inversion that stuck 0 rendered as permanently-true dots;
    SlaveWallas's non-inverted relay/led fields and MasterRemote's pFB read
    permanently false by the same mechanism (the long-documented FSD 12
    "don't trust output readbacks" limitation).
    GPIO_MODE_INPUT_OUTPUT additionally enables the read-back buffer (no
    electrical differen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
2026-07-03 Add WiFi tab with DHCP/static IP configuration to all four units
    Adds an always-accessible WiFi tab (network SSID/password + IP
    Configuration card) to every unit's web UI, defaulting to DHCP. Also
    fixes a latent gap where saving WiFi credentials from a running
    (non-portal) device never actually took effect: a new config_apply_task
    now watches for either save request and persists+reboots to apply,
    making the WiFi tab genuinely functional outside first-boot setup.
    MasterRemote 1.6.0, SlaveHonda 1.4.0, SlaveWallas 1.6.0, ESPNowRelay 1.1.0.
    Claude-Session: https://claude.ai/code/session_018BbmfyL8cKA5voQeYfWNAZ
2026-07-03 WiFi tab: suggest current IP when switching to static, add reboot button
    Selecting Static IP now pre-fills empty fields with the unit's current
    live IP/mask/gateway as a starting suggestion. Also adds a Device card
    with a manual Reboot Now button (POST /api/reboot) to all four units'
    WiFi tab.
    MasterRemote 1.6.1, SlaveHonda 1.4.1, SlaveWallas 1.6.1, ESPNowRelay 1.1.1.
    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
2026-07-04 Standardize Debug tab across all four units
    Rename SlaveHonda/SlaveWallas's "Debug GPIO" tab to "Debug", and add a
    new Debug tab to MasterRemote and ESPNowRelay (neither had one before).
    WiFi Link and System cards move off the Status/Pin Status tab onto
    Debug on all four units, keeping Status focused on operational state.
    MasterRemote 1.6.3, SlaveHonda 1.4.3, SlaveWallas 1.6.3, ESPNowRelay 1.1.3.
    Claude-Session: https://claude.ai/code/session_011GRoypACCotKWkifxtytsi
2026-07-04 Show ESP-NOW RSSI/channel on slaves' own Debug tab
    SlaveHonda/SlaveWallas already tracked the RSSI/channel of the last
    ESP-NOW frame heard from MasterRemote (sent in every heartbeat for
    MasterRemote's Nodes tab), but a slave had no way to see its own
    ESP-NOW link quality without checking a different device. Exposed the
    existing g_espnow_rssi/g_espnow_channel globals to web_server.c and
    added them to /api/status and the Debug tab's Radio Link card
    (renamed from WiFi Link) alongside the existing WiFi AP RSSI/channel.
    SlaveHonda 1.4.4, SlaveWallas 1.6.4.
    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
2026-07-04 Show device MAC addresses on every unit's own Radio Link card
    Add own STA MAC to /api/status on all four units, add MasterRemote's
    MAC to the slaves' Radio Link card (already tracked internally but
    never exposed), and add a per-peer ESP-NOW RSSI+MAC summary to
    ESPNowRelay's Debug tab (renamed WiFi Link -> Radio Link). Previously
    MAC addresses were only visible remotely (MasterRemote's Nodes tab,
    ESPNowRelay's Peers table), never on a unit's own page.
    MasterRemote 1.6.4, SlaveHonda 1.4.5, SlaveWallas 1.6.5, ESPNowRelay 1.1.4.
    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
2026-07-04 Restore Wallas Manual switch as a live start source on MasterRemote
    The physical switch was reconnected to GPIO5 (previously permanently
    unwired/obsolete as of v1.29). It's a maintained on/off toggle, active
    LOW like GPIO4, and OR's in as a plain level source alongside the
    Victron relay, web override, and weekly timer across all four
    recompute sites.
    Claude-Session: https://claude.ai/code/session_01LdKzyHHfJ2eewMtYWFMHAX
2026-07-04 Fix Wallas Manual switch polarity: non-inverted, not active-LOW
    The previous commit assumed GPIO5 would mirror GPIO4's active-LOW
    polarity. Live /api/status data (pWM read true with the switch in Off
    position, under the old inverted formula) showed the raw pin is
    actually LOW when Off -- the opposite of what was assumed, and instead
    matching GPIO14's Honda manual switch convention (non-inverted, grounds
    when idle/off). Caught before OTA deploy; never reached the physical
    device. Fixed all four recompute sites plus the pWM diagnostic field
    to read the pin non-inverted.
    Claude-Session: https://claude.ai/code/session_01LdKzyHHfJ2eewMtYWFM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
2026-07-08 Fix GitHub-releases OTA install failing on real hardware (begin:ESP_FAIL)
    GitHub's release-asset redirect target is a signed URL ~2KB long;
    esp_http_client's TX request-line buffer (buffer_size_tx, separate from
    the RX buffer_size already bumped in v1.45) still defaulted to 512
    bytes, silently failing to build the redirected GET request. Root
    cause found live via a new HTTP-event trace (esp_tls error decoding
    included) added specifically because these units have no USB/serial
    access in normal operation -- kept permanently as a diagnostic,
    exposed via /api/ota/github/progress's new "trace" field.
    Verified end-to-end on ESPNowRelay before rolling out to the other
    three: release fetched, insta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
2026-08-08 Fix GitHub-release OTA: streaming release parse + LWIP socket headroom
    Two independent defects, both surfacing as the GitHub OTA feature not working.
    1. The release listing buffered the whole API response and handed it to
    cJSON. With four per-unit assets per release the payload had grown past
    68 KB, and a full parse needs the raw buffer plus a tree several times
    its size against a ~200 KB heap. MasterRemote failed 3/3 with
    'Bad GitHub response' (the cJSON_Parse branch), heap low-water dropping
    ~98 KB per attempt; SlaveHonda had just enough headroom to pass 9/9,
    which is why it looked intermittent rather than systematic. Replaced
    with a byte-at-a-time streaming scanner k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
2026-08-08 Add GitHub/Stored/Installed firmware version table to the OTA tab
    Every unit's OTA tab now opens with a version card: the newest version
    published on GitHub for that unit, the version sitting in its inactive OTA
    slot, and the version running. MasterRemote's card covers all four units in
    one table; the others show themselves.
    - GET /api/version on all four units (installed + inactive-slot version,
    read via esp_ota_get_partition_description). CORS-open, because
    MasterRemote's page fetches it from the other units' addresses.
    - GET /api/ota/github/latest on all four units: newest version per unit,
    parsed from the <Unit>_v<ver>.bin asset names using v1.48's streaming
    scanner, stopping on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
2026-08-08 Fix empty slave rows in the version table, and use a 24-hour clock
    MasterRemote showed no versions for the slaves: v1.49 had the page fetch
    /api/version from each slave's own address, which is cross-origin from the
    page MasterRemote served, and those reads came back empty on real hardware
    despite the CORS header. MasterRemote now collects them itself:
    - GET /api/versions[?relay=<ip>] on MasterRemote returns all four rows,
    fetching the slaves' /api/version over LAN HTTP with a 4 s timeout each so
    one silent unit leaves an empty row instead of stalling the table. The
    relay address (still browser-held, since the relay is absent from the
    ESP-NOW roster) is passed as a query param, valid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
2026-08-08 Collapse the idle blank space in the GitHub Releases card
    The card reserved roughly 70px of permanent empty space for controls that
    only appear once an install is running: a <br> after the always-hidden
    release select, and two .prog status lines each holding min-height:1.2em
    while empty.
    - Dropped the <br>; the select is switched to display:block when populated,
    so the Install button still lands on its own line.
    - Added .prog:empty{display:none}, which collapses every idle status line on
    the page, not just this card's.
    CSS and markup only, all four units. MasterRemote 1.6.15, SlaveHonda 1.4.13,
    SlaveWallas 1.6.13, ESPNowRelay 1.1.12. FSD v1.51.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
2026-08-10 Add hardware guide: MasterRemote wiring and Honda start flow
    New docs/HARDWARE.md plus the three source drawings under docs/hardware/:
    MasterRemote's opto-isolated Victron Venus (Raspberry Pi) interface board,
    the manual-switch/indicator field wiring and terminal-block assignments, the
    end-to-end Honda start flow through to the EU7000is remote connector, and the
    relay timing.
    Corrects FSD 2.2: GPIO15 (Honda Start, Victron relay) is active LOW, not
    active HIGH. The table had claimed active HIGH since v1.14 while main.c has
    always read it as !gpio_get_level(PIN_HONDA_START). The schematic settles it --
    GPIO15 is fed by optocoupler U1's open collector with an external 10k pull-up,
    and the inte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
2026-09-13 Split the FSD into a clean spec and a separate changelog (FSD v1.53)
    Documentation only - no firmware, endpoint or NVS change, and no unit version
    bump.
    FSD_RemoteStart.md is now the clean current specification: what the system is
    required to do, present tense, no history. FSD_RemoteStart_CHANGELOG.md takes
    the development record, newest first, with all 51 existing entries moved across
    byte-for-byte.
    This FSD was the mildest of the family - 68 lines of changelog against 782
    total, against AlthermaInterface's 671 of 884 - so the split buys less here than
    elsewhere. It is done anyway because the same change has now been applied to
    PowerMeter, AlthermaInterface and BirdBox, and a half-migrate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
2026-10-11 Add a browser flasher for new units on GitHub Pages (FSD v1.54)
    Same esp-web-tools pattern as BirdBox, extended to four units on two chip
    families: webflash-pages.yml builds all four on push to master and publishes
    each unit's bootloader/partition table/otadata/app with its own manifest
    (bootloader at 0x1000 on ESP32, 0x0 on ESP32-C6). One install button per unit.
    Also fixes the release notes' USB instructions, which wrote only the app image
    at 0x10000 and would not boot a blank board.
    Claude-Session: https://claude.ai/code/session_01FfZf9GEuCRhkpHS6F2x9yk
2026-10-11 MasterRemote 1.7.0: unconnected inputs no longer demand a start (FSD v1.55)
    A bare MasterRemote with nothing wired commanded both Honda and Wallas on:
    GPIO15/GPIO4 floated LOW (internal pull-ups were disabled, relying on the
    interface board's 10k) and the manual-switch inputs read HIGH = On.
    - Enable internal pull-ups on GPIO15/GPIO4, so an absent board reads idle.
    - Add an input enable mask (Debug > Input Sources, POST /api/inputs/set,
    NVS "inen", inEn in /api/status), all enabled by default, for inputs that
    are not wired. A manual-switch wire break still reads On by wiring.
    - Route every recompute site through honda_cmd_compute()/wallas_cmd_compute().
    Claude-Session: https://claude.a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
2026-10-11 SlaveWallas runs standalone; weekly timer synced with MasterRemote (FSD v1.56)
    SlaveWallas 1.7.2: with no MasterRemote beacon for 30 s it drives the relay
    from its own Start/Stop buttons (Status tab) and its own Weekly Timer tab
    (SNTP, same table as Master's). With Master present it follows Master as
    before; its buttons act as Master's own web Start/Stop, and a local Start made
    while standalone is handed to Master when it returns.
    Timer sync over ESP-NOW, newest edit wins: new wallas_timer_msg_t (71 B) and
    wallas_webcmd_msg_t (33 B), packed and size-asserted. MasterRemote 1.8.2
    handles both and force-sends the Wallas command on (re)registration;
    ESPNowRelay 1.2.0 forwards both.
    Both Weekly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
2026-10-11 Document the Wallas heater wiring and the planned SlaveWallas relay module (FSD v1.57)
    Hardware guide 1.1: the Wallas 12 V control block (6 -, 5 +, 4 joined to 5 =
    heater on), the vendor drawing with its notes translated, and the wiring for
    an ESP32-C6 single-relay module (supply from 5/6, COM to 5, NO to 4). The
    module's relay GPIO is still to be found on the bench.
    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
2026-10-11 Hardware guide: the installed heater is an older Wallas M26
    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
2026-10-11 Remove the old Arduino sketches (FSD v1.58)
    Five .ino files no build used: MasterHonda.ino, SlaveHonda.ino,
    SlaveWallas.ino and two identical copies of SlaveWallas8266.ino. Still in
    history; the last commit with them is fbca35c.
    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
2026-10-11 Add safety precautions and a use-at-your-own-risk disclaimer for the Wallas wiring (FSD v1.59)
    The Wallas wiring comes from a third-party drawing for one older M26 and is
    not verified for other heaters, while the system starts a fuel-burning heater
    remotely and unattended. Hardware guide 1.2 opens §3 with a CAUTION block
    (check the heater's own documentation, measure, keep its safety functions in
    charge, fuse, NO contact, test while present, don't connect if unsure) and a
    no-warranty / no-liability disclaimer; the guide's top and the README point
    to it.
    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
2026-10-11 Hardware guide: link an example (unverified) eBay listing for the SlaveWallas relay module
    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
2026-10-11 Add the MIT license (FSD v1.60)
    Same license and holder as BirdBox. The README's new License section points
    to the safety disclaimer and notes that the Wallas wiring drawing and the
    relay-module photo are third-party material, not covered by the license.
    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
2026-10-11 README: SlaveWallas screenshots (standalone Status tab, Weekly Timer tab)
    Taken by the user from the test SlaveWallas on 1.7.2.
    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
2026-10-11 Units answer on <unit>.local; setup page redirects there by itself (FSD v1.61)
    All four units set a DHCP hostname and announce themselves over mDNS
    (masterremote, slavehonda, slavewallas, espnowrelay .local; espressif/mdns, as
    BirdBox). After Connect & Save or Save & Apply, the Saved! page polls the
    unit's .local name and opens it as soon as the unit is back on the home
    network, keeping a manual fallback. A note under each save button says so up
    front. MasterRemote 1.9.0, SlaveHonda 1.5.0, SlaveWallas 1.8.0,
    ESPNowRelay 1.3.0. Verified end to end on the test SlaveWallas.
    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
2026-10-11 Relay module's relay is on GPIO19 - runs standard SlaveWallas firmware (FSD v1.62)
    Confirmed on the bench: three Start/Stop pulses, three clicks. Hardware guide
    3.2 no longer says 'not yet known'; session notes updated.
    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
2026-10-16 README: relay module thumbnail in SlaveWallas screenshots; cleaner product photo crop
    Claude-Session: https://claude.ai/code/session_01Y35GLsdNot6F4rkygnPYm4
